WOSS-SmartHome/-smart-home-DOC/README.md

# DOC smart-home
 Lưu giữ các tài liệu chung của dự án
