WOSS-SmartHome/-smart-home-DOC/BOM list smarthome 6-sep.xlsx

Sheet: LN1_ACS71240
Comment | Description | Designator | Footprint | LibRef | Quantity
0.1uF | CAP CER 0.1uF 50V 10% 0603 SMD | C1, C2, C3, C4, C5, C6, C8 | 0603 C | 0603 0.1uF CER | 7
1nF | CAP CER 1nF 50V 10% 0603 SMD | C7, C9 | 0603 C | 0603 1nF CER | 2
1N4148 |  | D1, D2, D3, D4, D5, D6 | SOD-323 | Diode schottky | 6
TS4148C |  | D7, D8, D9 | 0603 D | Diode schottky | 3
LED smd |  | D10 | LED 0805 | LED smd | 1
FUSE |  | F1, F2, F3 | FUSE 6ET 10A250V | FUSE | 3
P5 1.27MM |  | JP1 | P5-1.27MM | P5 | 1
P1 |  | L1, N1, O1, O2, O3 | BRASS CONN | P1 | 5
10D751K | 750V | MOV1 | MOV | VARISTOR | 1
3904 |  | Q1, Q2, Q4, Q5, Q6, Q8, Q9, Q10, Q12 | SOT 23-3 - BCE | TRANS NPN_BCE | 9
3906 |  | Q3, Q7, Q11 | SOT 23-3 - BCE | TRANS PNP_BCE | 3
10k | 10k 1% 0603 SMD | R1, R2, R4, R5, R8, R9, R11, R12, R13, R14, R16, R20, R27, R29, R42, R45 | 0603 R | 0603 10k 1% | 16
0R | 0R 1% 0603 SMD | R3 | 0603 R | 0603 0R 1% | 1
100k | 100k 1% 0603 SMD | R6, R7, R10, R15, R18, R19, R30, R31, R41, R46, R47, R48, R49 | 0603 R | 0603 100k 1% | 13
RELAY CHOT |  | RL1, RL2, RL3 | HFE60 | RELAY CHOT | 3
P4 |  | SW1 | JST 4PIN - 2.54mm | P4 | 1
N76E003AT20 |  | U1 | TSSOP 20 P0.65 | N76E003_1 | 1
HC12 MODULE |  | U2 | P5 - 2.54mm | HC12 MODULE | 1
AC-DC 5V |  | U3 | AC-DC 5V K4H24 | P4 | 1
ACS712ELCTR-30A-T | ACS712ELCTR-20A SOIC 8 | U4 | SOIC 8 | ACS71240 | 1

Sheet: L
Comment | Description | Designator | Footprint | LibRef | Quantity
0.1uF | CAP CER 0.1uF 50V 10% 0603 SMD | C1, C2, C3, C5, C7, C8 | 0603 C | 0603 0.1uF CER | 6
1nF | CAP CER 1nF 50V 10% 0603 SMD | C4, C6 | 0603 C | 0603 1nF CER | 2
TAJA225K016RNJ | CAP-TAN 2.2uF 16V 10% 3216 SMD | C9, C10, C12, C13 | CAP-TAN 3216 | CAP-TAN 2.2uF 16V 3216 SMD | 4
TAJD227K010RNJ | CAP-TAN 220uF 10V 10% 7343 SMD | C14 | CAP-TAN 7343 | CAP-TAN 220uF 10V7343 SMD_1 | 1
TS4148C |  | D1, D2 | 0603 D | Diode schottky | 2
LED smd |  | D3 | LED 0805 | LED smd | 1
1N4007 |  | D4, D8 | DO214AC | Diode schottky | 2
0603 |  | D5, D12 | LED0603_1608 | LED smd | 2
SMAJ4735A | DIODE ZENER 6.2V 1W | D6, D7, D13, D14 | DO214AC | Diode Zener | 4
ZMM5V1 |  | D9, D10, D11 | SOD-80C | Diode Zener | 3
FUSE |  | F1, F2 | FUSE 6ET 10A250V | FUSE | 2
P5 1.27MM |  | JP1 | P5-1.27MM | P5 | 1
P1 |  | L1, O1, O2 | HOLE AC | P1 | 3
HC12 MODULE |  | P1 | HC12 MODULE | HC12 MODULE | 1
3906 |  | Q1, Q2 | SOT 23-3 - BCE | TRANS PNP_BCE | 2
3904 |  | Q3, Q4 | MMBT3904-SOT23 | TRANSITOR NPN | 2
10k | 10k 1% 0603 SMD | R1, R2, R4, R7, R13, R16 | 0603 R | 0603 10k 1% | 6
0R | 0R 1% 0603 SMD | R3 | 0603 R | 0603 0R 1% | 1
100k | 100k 1% 0603 SMD | R5, R6, R8, R14, R17 | 0603 R | 0603 100k 1% | 5
100R | 100R 1% 0603 SMD | R9, R11, R15 | 0603 R | 0603 100R 1% | 3
470R | 470R 1% 0603 SMD | R10, R12 | 0603 R | 0603 470R 1% | 2
P3 |  | SW1 | JST 3PIN - 2.54mm | P3 | 1
N76E003AT20 |  | U1 | TSSOP 20 P0.65 | N76E003_1 | 1
AC-DC 5V |  | U2 | DC-DC ISO BxxS LET | P4 | 1
ACS712ELCTR-30A-T | ACS712ELCTR-20A SOIC 8 | U3 | SOIC 8 | ACS71240 | 1
MOC3062 |  | U4, U6 | 6-PIN DIP | TRIAC & SCR | 2
DIODE BRIGH |  | U5 | MDB10S_MICRODIP_4SMD | DIODE BRIGH | 1
ACJT210 |  | U7, U8 | TO-252 | TRIAC | 2

Sheet: LN2
Comment | Description | Designator | Footprint | LibRef | Quantity
0.1uF | CAP CER 0.1uF 50V 10% 0603 SMD | C1, C2, C3, C5, C7, C10, C12 | 0603 C | 0603 0.1uF CER | 7
1nF | CAP CER 1nF 50V 10% 0603 SMD | C4, C6, C8, C9 | 0603 C | 0603 1nF CER | 4
TS4148C |  | D1, D2, D4, D5 | 0603 D | Diode schottky | 4
1N4148 |  | D3, D6 | SOD-323 | Diode schottky | 2
LED smd |  | D7 | LED 0805 | LED smd | 1
P5 1.27MM |  | JP1 | P5-1.27MM | P5 | 1
P1 |  | L, N, O1, O2 | HOLE AC | P1 | 4
10D751K | 750V | MOV1 | MOV | VARISTOR | 1
HC12 MODULE |  | P | HC12 MODULE | HC12 MODULE | 1
3904 |  | Q1, Q4 | SOT 23-3 - BCE | TRANS NPN_BCE | 2
3906 |  | Q2, Q3 | SOT 23-3 - BCE | TRANS PNP_BCE | 2
10k | 10k 1% 0603 SMD | R1, R2, R5, R6, R8, R11 | 0603 R | 0603 10k 1% | 6
0R | 0R 1% 0603 SMD | R3 | 0603 R | 0603 0R 1% | 1
100k | 100k 1% 0603 SMD | R4, R7, R9, R10, R12 | 0603 R | 0603 100k 1% | 5
SRA-05VDC-CL | 5VDC, 20A | RL1, RL2 | SRA-05VDC-CL | RELAY | 2
P3 |  | SW | JST 3PIN - 2.54mm | P3 | 1
N76E003AT20 |  | U1 | TSSOP 20 P0.65 | N76E003_1 | 1
AC-DC 5V |  | U2 | AC-DC 5V K4H24 | P4 | 1
ACS712ELCTR-30A-T | ACS712ELCTR-20A SOIC 8 | U3, U4 | SOIC 8 | ACS71240 | 2

Sheet: LN-WIFI
Comment | Description | Designator | Footprint | LibRef | Quantity
10uF | CAP CER 10uF 50V 10% 0805 SMD | C1, C9, C10 | 0805 C | 0805 10uF CER | 3
0.1uF | CAP CER 0.1uF 50V 10% 0603 SMD | C2, C3, C4, C5, C7 | 0603 C | 0603 0.1uF CER | 5
1nF | CAP CER 1nF 50V 10% 0603 SMD | C6, C8 | 0603 C | 0603 1nF CER | 2
TS4148C |  | D1 | 0603 D | Diode schottky | 1
LED smd |  | D2, D5 | LED0603_1608 | LED smd | 2
1N4148 |  | D3, D4 | SOD-323 | Diode schottky | 2
FUSE |  | F1 | FUSE 6ET 10A250V | FUSE | 1
P6 |  | JP1 | P6 - 1.27MM | P6 | 1
P1 |  | L1, O1 | BRASS CONN | P1 | 2
VARISTOR |  | MOV1 | MOV | VARISTOR | 1
P1 |  | N1 | HOLE AC | P1 | 1
3906 |  | Q1 | SOT 23-3 - BCE | TRANS PNP_BCE | 1
3904 |  | Q2, Q3, Q4 | SOT 23-3 - BCE | TRANS NPN_BCE | 3
10k | 10k 1% 0603 SMD | R1, R5, R8, R9, R10, R11, R15, R18 | 0603 R | 0603 10k 1% | 8
0R | 0R 1% 0603 SMD | R2, R3, R6 | 0603 R | 0603 0R 1% | 3
8.2k | 8.2k 1% 0603 SMD | R4 | 0603 R | 0603 8.2k 1% | 1
1k | 1k 1% 0603 SMD | R7 | 0603 R | 0603 1kR 1% | 1
100k | 100k 1% 0603 SMD | R12, R13, R14, R16, R17 | 0603 R | 0603 100k 1% | 5
P4 |  | RF1 | MODULE RF THU -2 | P4 | 1
RELAY CHOT |  | RL1 | HFE60 | RELAY CHOT | 1
P2 |  | SW | P2-2.54-SOCKET - RA | P2 | 1
MICRO-32 | MICRO-32 | U1 | ESP MICRO 32 | ESP MICRO-32 | 1
HC12 MODULE |  | U2 | HC12 MODULE | HC12 MODULE | 1
AC-DC 5V |  | U3 | AC-DC 5V K4H24 | P4 | 1
ACS712ELCTR-30A-T | ACS712ELCTR-20A SOIC 8 | U4 | SOIC 8 | ACS71240 | 1
LM1117 |  | U5 | SOT23-4 | LM1117 | 1

Sheet: SOCKET
Comment | Description | Designator | Footprint | LibRef | Quantity
B0505S |  | B1 | DC-DC ISO BxxS | P4 | 1
0.1uF | CAP CER 0.1uF 50V 10% 0603 SMD | C1, C2, C3, C6, C7, C10, C11 | 0603 C | 0603 0.1uF CER | 7
33nF | CAP CER 33nF 50V 10% 0603 SMD | C4, C5, C8, C9 | 0603 C | 0603 33nF CER | 4
TS4148C |  | D1, D2 | 0603 D | Diode schottky | 2
1N4148 |  | D3, D4, D7, D8 | SOD-323 | Diode schottky | 4
LED smd |  | D5, D6 | LED0603_1608 | LED smd | 2
FUSE |  | F1, F2 | FUSE 6ET 10A250V | FUSE | 2
P5 1.27MM |  | JP1 | P5-1.27MM | P5 | 1
P1 |  | L, N, O1, O2 | HOLE AC | P1 | 4
VARISTOR |  | MOV1 | MOV | VARISTOR | 1
HC12 MODULE |  | P | HC12 MODULE | HC12 MODULE | 1
3904 |  | Q1, Q4, Q5, Q6 | SOT 23-3 - BCE | TRANS NPN_BCE | 4
3906 |  | Q2, Q3 | SOT 23-3 - BCE | TRANS PNP_BCE | 2
10k | 10k 1% 0603 SMD | R1, R2, R4, R6, R8, R13, R27 | 0603 R | 0603 10k 1% | 7
0R | 0R 1% 0603 SMD | R3 | 0603 R | 0603 0R 1% | 1
100k | 100k 1% 0603 SMD | R5, R7, R9, R17, R29 | 0603 R | 0603 100k 1% | 5
1k | 1k 1% 0603 SMD | R10, R11, R12, R16, R18, R26, R28, R30, R31, R32, R35, R36, R44, R45 | 0603 R | 0603 1kR 1% | 14
5mR | 5mR 1% 2512 SMD | R14, R33 | 2512 R | RES 2512 5mR 1% | 2
330R | 330R 1% 0603 SMD | R15, R25, R34, R43 | 0603 R | 0603 330R 1% | 4
470k | 470k 1% 0805 SMD | R19, R20, R21, R22, R23, R24, R37, R38, R39, R40, R41, R42 | 0805 R | 0805 470k 1% | 12
G5RL-K1A-EL-HA |  | RL1, RL2 | RELAY LATCHING | RELAY 1 coil G5RL-K1A-EL-HA | 2
N76E003AT20 |  | U1 | TSSOP 20 P0.65 | N76E003_1 | 1
AC-DC 5V |  | U2 | AC-DC 5V K4H24 | P4 | 1
HLW8012 |  | U3, U7 | SOIC 8 | HLW8012 | 2
OPTO PC817 |  | U4, U5, U6, U8, U9, U10 | PC817 Tiny | OPTO | 6

Sheet: TỔNG HỢP
Comment | Description | Supplier | Footprint | LibRef | Quantity | LN1 | L | LN2 | LN-WIFI | SOCKET | IR | buy = qty*5
0.1uF | CAP CER 0.1uF 50V 10% 0603 SMD | theioiic | 0603 C | 0603 0.1uF CER | 32 | 7 | 6 | 7 | 5 | 7 |  | 160
1nF | CAP CER 1nF 50V 10% 0603 SMD | theioiic | 0603 C | 0603 1nF CER | 10 | 2 | 2 | 4 | 2 |  |  | 50
10uF | CAP CER 10uF 50V 10% 0805 SMD | C1, C9, C10 | 0805 C | 0805 10uF CER | 3 |  |  |  | 3 |  |  | stock
TAJA225K016RNJ | CAP-TAN 2.2uF 16V 10% 3216 SMD | theioiic | CAP-TAN 3216 | CAP-TAN 2.2uF 16V 3216 SMD | 4 |  | 4 |  |  |  |  | 20
TAJD227K010RNJ | CAP-TAN 220uF 10V 10% 7343 SMD | theioiic | CAP-TAN 7343 | CAP-TAN 220uF 10V7343 SMD | 1 |  | 1 |  |  |  |  | 5
TAJA106M010RNJ | Tantalum 10uF 10V | theioiic |  |  | 2 |  |  |  |  |  |  | 10
33nF | CAP CER 33nF 50V 10% 0603 SMD | theioiic | 0603 C | 0603 33nF CER | 4 |  |  |  |  | 4 |  | 20
10k | 10k 1% 0603 SMD | R1, R2, R4, R5, R8, R9, R11, R12, R13, R14, R16, R20, R27, R29, R42, R45 | 0603 R | 0603 10k 1% | 43 | 16 | 6 | 6 | 8 | 7 |  | stock
0R | 0R 1% 0603 SMD | R3 | 0603 R | 0603 0R 1% | 7 | 1 | 1 | 1 | 3 | 1 |  | 35
100k | 100k 1% 0603 SMD | R6, R7, R10, R15, R18, R19, R30, R31, R41, R46, R47, R48, R49 | 0603 R | 0603 100k 1% | 33 | 13 | 5 | 5 | 5 | 5 |  | stock
100R | 100R 1% 0603 SMD | theioiic | 0603 R | 0603 100R 1% | 3 |  | 3 |  |  |  |  | 15
470R | 470R 1% 0603 SMD | theioiic | 0603 R | 0603 470R 1% | 2 |  | 2 |  |  |  |  | 10
1k | 1k 1% 0603 SMD | theioiic | 0603 R | 0603 1kR 1% | 15 |  |  |  | 1 | 14 |  | 75
8.2k | 8.2k 1% 0603 SMD | theioiic | 0603 R | 0603 8.2k 1% | 1 |  |  |  | 1 |  |  | 5
330R | 330R 1% 0603 SMD | theioiic | 0603 R | 0603 330R 1% | 4 |  |  |  |  | 4 |  | 20
470k | 470k 1% 0805 SMD | R19, R20, R21, R22, R23, R24, R37, R38, R39, R40, R41, R42 | 0805 R | 0805 470k 1% | 12 |  |  |  |  | 12 |  | stock
5mR | 5mR 1% 2512 SMD | R14, R33 | 2512 R | RES 2512 5mR 1% | 2 |  |  |  |  | 2 |  | stock
1N4148 |  | theioiic | SOD-123 | Diode schottky | 14 | 6 |  | 2 | 2 | 4 |  | 70
TS4148C |  | theioiic | 0603 D | Diode schottky | 12 | 3 | 2 | 4 | 1 | 2 |  | 60
1N4007 |  | theioiic | DO214AC | Diode schottky | 2 |  | 2 |  |  |  |  | 10
1N4736A | DIODE ZENER 6.8V 1W | theioiic | DO214AC | Diode Zener | 4 |  | 4 |  |  |  |  | 20
ZMM5V1 |  | theioiic | SOD-80C | Diode Zener | 3 |  | 3 |  |  |  |  | 15
LED smd |  | theioiic | LED 0603 | LED smd | 9 | 1 | 3 | 1 | 2 | 2 |  | 45
FUSE | 250V 10A | dientuachau | FUSE 6ET 10A250V | FUSE | 8 | 3 | 2 |  | 1 | 2 |  | 40
P1 | Trụ PCB Nối Dây 5x6x9.5 V3 | theioiic | BRASS CONN | P1 | 7 | 5 |  |  | 2 |  |  | 35
10D751K | VARISTOR 750V | theioiic | MOV | VARISTOR | 4 | 1 |  | 1 | 1 | 1 |  | 20
3904 |  | theioiic | SOT 23-3 - BCE | TRANS NPN_BCE | 20 | 9 | 2 | 2 | 3 | 4 |  | 100
3906 |  | theioiic | SOT 23-3 - BCE | TRANS PNP_BCE | 10 | 3 | 2 | 2 | 1 | 2 |  | 50
RELAY CHOT |  | RL1, RL2, RL3 | HFE60 | RELAY CHOT | 4 | 3 |  |  | 1 |  |  | stock
SRA-05VDC-CL | 5VDC, 20A | RL1, RL2 | SRA-05VDC-CL | RELAY | 2 |  | 2 |  |  |  |  | 10
G5RL-K1A-EL-HA |  | RL1, RL2 | RELAY LATCHING | G5RL-K1A-EL-HA | 2 |  |  |  |  | 2 |  | stock
P4 | header 4 | SW1 | JST 4PIN - 2.54mm | P4 | 1 | 1 |  |  |  |  |  | 5
P3 | header 3 | SW1 | JST 3PIN - 2.54mm | P3 | 2 |  | 1 | 1 |  |  |  | 10
P2 | header 2 | SW | P2-2.54-SOCKET - RA | P2 | 1 |  |  |  | 1 |  |  | 5
CHJ-RXB1 | RF R 433MHz |  |  |  | 2 |  |  |  | 1 |  | 1 | stock
HC12 MODULE |  | theioiic | P5 - 2.54mm | HC12 MODULE | 5 | 1 | 1 | 1 | 1 | 1 |  | 25
N76E003AT20 |  | dientuachau | TSSOP 20 P0.65 | N76E003_1 | 4 | 1 | 1 | 1 |  | 1 |  | 20
AC-DC 5V |  | dientuachau | AC-DC 5V K4H24 | P4 | 4 | 1 |  | 1 | 1 | 1 |  | 20
ACS712ELCTR-30A-T |  | theioiic | SOIC 8 | ACS71240 | 2 |  |  | 2 |  |  |  | 10
ACS712ELCTR-20A-T |  | theioiic |  |  | 3 | 1 | 1 |  | 1 |  |  | 15
MICRO-32 | MICRO-32 | U1 | ESP MICRO 32 | ESP MICRO-32 | 2 |  |  |  | 1 |  | 1 | 10
LM1117 |  | U5 | SOT23-4 | LM1117 | 2 |  | 1 |  | 1 |  |  | stock
HLW8012 |  | U3, U7 | SOIC 8 | HLW8012 | 2 |  |  |  |  | 2 |  | 10
OPTO PC817 |  | U4, U5, U6, U8, U9, U10 | PC817 Tiny | OPTO | 6 |  |  |  |  | 6 |  | stock
MOC3063M |  | theioiic | 6-PIN DIP | TRIAC & SCR | 2 |  | 2 |  |  |  |  | 10
DB107S | diode bridge 1kV 1A | theioiic | MDB10S_MICRODIP_4SMD | DIODE BRIGH | 1 |  | 1 |  |  |  |  | 5
BT137S-600E |  | theioiic | TO-252 | TRIAC | 2 |  | 2 |  |  |  |  | 10

Sheet: Sheet6
Supplier | ID | pass
thegioiic.com | dientu@woss.com.vn | thegioiic
banlinhkien.com | dientu@woss.com.vn | banlinhkien
dientuachau.com | dientu@woss.com.vn | dientuachau

Sheet: Sheet1
No | Comment | Description | Designator | Quantity | Manufacture PN
1 | 0.1uF | CAP CER 0.1uF 25V 10% 0603 SMD | C1, C3, C10, C11, C12, C14 | 2 | GMC10X7R104J25NT
2 | 10uF | CAP CER 10uF 25V 10% 0805 SMD | C2, C5, C6 | 3 | 08053D106KAT4A
3 | 0.1uF | CAP CER 0.1uF 25V 10% 0805 SMD | C7, C8, C9 | 1 | CC0805ZRY5V8BB104
4 | LED 3MM | LED BLUE DIP 3MM | D2 | 1
5 | IR333-A | EMITTER IR 940NM 100MA RADIAL | IR2, IR3, IR4, IR5, IR6, IR7, IR8 | 7 | IR333-A
6 | TSOP1838 | TSOP1838 IR Receiver Module 38 kHz | IR1 | 1
7 | IRLML0030TRPBF | MOSFET N-CH 30V 5.3A SOT-23-3 | Q1 | 1 | FDV303N
8 | 10K | CRGCQ 0603 10K 1% | R1, R5,R7, R8 | 3 | A129700TR-ND
9 | 1K | RES 1K OHM 0.5% 1/10W 0603 | R2 | 1 | RNCF0603DTE1K00
10 | 35R | RES 35.7 OHM 1% 1/10W 0603 | R9, R10, R11, R12, R13, R14, R15 | 7 | RMCF0603FT35R7
11 | SW | Button 4 Pin SMD | SW3.5 | 1
12 | MICRO 32 | TTGO Micro-32 V2.0 WifiBluetooth Module ESP32 | U1 | 1
13 | LM1117 | IC REG LIN 3.3V 1mA SOT223-4 | U2 | 1
14 | USB Micro 2.0 | MICRO USB, TYPE B, RIGHT ANGLE,' | USB1 | 1 | MCR-B-S-RA-SMT-CS5A-NF-T/R
15 | ATSHA204A | IC AUTHENTICATION CHIP SOT23-3 | U3 | 1 | ATSHA204A-STUCZ-T
16 | 3.3K | RES 3.3K OHM 1% 1/10W 0603 | R16, R17, R18, R19 | 4 | RMCF0603FT3K30
17 | SN74LVC125A | IC BUF NON-INVERT 3.6V 14TSSOP | U4 | 1 | SN74LVC125AQPWRQ1
18 | Socket MicrO SD Push-Push | CONN MEM SECURE DIGITAL REV SMD | SD1 | 1
19 | RXB22 | RF 433Hz | RF | 1
