WOSS-SmartHome/-smart-home-DOC/Daily_Testing_Module-Zigbee-Ti-CC2530.xlsx

Sheet: Overview
TEST MODULE ZIGBEE TI CC2530
THIẾT BỊ:
5 module Zigbee Ti cc2530. Các module được đặt tên A, B, C, D, E như hình bên dưới
 |  | CẤU HÌNH:
 |  | Baudrate 9600:
 |  | Phương thức truyền: Broadcast
NHIỆM VỤ: | Test khoảng cách, thời gian và độ ổn định khi truyền nhận dữ liệu giữa các module
1. Test hoạt động truyền nhận tín hiệu của mỗi module
2. Test truyền nhận tín hiệu qua cổng UART giữa nhiều module (3, 4, 5,… module) đặt cùng vị trí
3. Test truyền nhận tín hiệu giữa 2 module (A truyền, B nhận) khi có thêm các module khác đặt giữa (mục đích mở rộng không gian truyền nhận tín hiệu)
- Case 1: Chỉ có module C đặt giữa A và B
- Case 2: Có module C và D đặt giữa A và B
- Case 3: Có module C, D, E đặt giữa A và B
4. Test truyền nhận tín hiệu khi lắp module (thay cho HC-12) vào PCB và đặt vào trong tường

Sheet: Working timeline
Thời gian | Công việc
Thứ sáu, 15/10/2021 | 1. Nhận 5 module Zigbee Ti CC2530
 | 2. Kết nối UART và Setup cấu hình cho từng module
 | 3. Test truyền nhận tín hiệu cho từng module
Thứ bảy, 16/10/2021 | 1. Test truyền nhận tín hiệu giữa nhiều module với nhau
Thứ hai, 18/10/2021 | 1. Test khoảng cách truyền nhận giữa module A và B
 | - Chỉ 2 module A và B
 | - Đặt module C giữa A và B
 | - Đặt module C, D và E giữa A và B
Thứ ba, 19/10/2021 | 1. Lắp module B vào PCB Smart Home (thay cho HC-12)
 | - Viết code, và nạp cho MCU gắn với module B (nhờ Trí)
 | - Test module với code đã nạp xem đã hoạt động đúng chưa
 | 2. Lắp bo mạch đã có module C vào công tắc điện âm tường
 | 3. Test truyền nhận giữa A và B
Thứ tư, 20/10/2021 | 1. Test khoảng cách truyền nhận (cùng a Hải) các trường hợp
 | - Test truyền nhận giữa A và B (module B đã lắp âm tường)
 | - Đặt một module C giữa A và B
 | - Nối Tx và Rx của module C với nhau

Sheet: Testing
 | Test Case
 | Project Name | Smart Home | Tên Module | Zigbee Ti CC2530
 | Test Case ID |  | Tốc độ truyền | Baudrate 9600 | Description
 | Version | V00 | Chanel | 2 LED bên dưới đỏ | Pre - Condition
 | Created By | N.Q Cường | Kiểu truyền nhận | Broadcast | Created Date |  | Executed By
 | Reviewed By |  |  |  | Reviewed Date |  | Result ( Pass / Fail)
Test ID | Test Scenarios | Description | Test Step | Test Data | Expected Result | Actual result | Status | Comments
1 | Ghi trường hợp test | Mô tả tình huống test | Các bước thực hiện của tình huống test | Dữ liệu sử dụng để thực hiện / vận hành bài test | Kết quả dự kiến đối với test case | Kết quả thực tế sau khi thực hiện test case | Đánh giá: Thành công / Thất bại | Nhận xét / Bình luận
Test ID | Test Scenarios | Description | Test Step | Test Data | Expected Result | Actual result | Status | Comments
1 | Test hoạt động truyền nhận của các module ở khoảng cách gần | Test truyền nhận tín hiệu cho từng cặp module | B1. Kết nối UART module A và B vào máy tính B2. Trên máy tính, mở phần mềm Terminal lên và kết nối với các module B3. Gửi tín hiệu truyền từ A, kiểm tra xem A có truyền đi không và B có nhận được tín hiệu không. Chú ý đến thời gian và dữ liệu nhận được B4. Truyền ngược lại từ B qua A và kiểm tra tương tự B5. Tương tự, kiểm tra truyền nhận với các module C, D, E | - A phát - B thu: trên Terminal gửi " A to B" - B phát - A thu: trên Terminal gửi " B to A". Tương tự cho các module C, D, E | - Led Tx trên A nháy báo hiệu đã gửi tín hiệu tới B - Led Rx trên B nháy báo hiệu B đã nhận tín hiệu. Trên Terminalkết nối với B hiển thị "A to B" | Đúng với dự kiến và mong muốn | Thành công | - 5 module truyền nhận 1 - 1 tốt ở khoảng cách gần (1 - 5m). - Ở chế độ Broadcast, 1 module có thể truyền tín hiệu cho nhiều module khác và ngược lại, một module có thể nhận tín hiệu từ nhiều module khác.
 |  | Test truyền nhận nhiều module (3, 4, 5,... module) | B1. Kết nối UART module A, B, C, D, E vào máy tính B2. Trên máy tính, mở phần mềm Terminal lên và kết nối với các module B3. Gửi tín hiệu truyền từ A , kiểm tra xem A có truyền đi không và các module còn lại có nhận được tín hiệu không. Chú ý đến thời gian và dữ liệu nhận được B4. Tương tự, gửi tín hiệu truyền từ B (C, D, E,...) và kiểm tra dữ liệu nhận các module còn lại. | - A phát, các module còn lại thu: Trên Terminal đã kết nối với A, gửi chuỗi "A to all" - Tương tự cho các module còn lại | - Led Tx trên A nháy báo hiệu đã gửi tín hiệu tới các module còn lại (B, C, D, E) - Led Rx trên B, C, D, E nháy báo hiệu đã nhận tín hiệu từ A. Trên Terminalkết nối với chúng hiển thị "A to all" | Đúng với dự kiến và mong muốn | Thành công
2 | Test khoảng cách truyền nhận giữa các module | Case 1: Truyền nhận 1 - 1 giữa A và B | B1. Chuẩn bị: - Kết nối UART module A vào laptop A/máy tính; module B vào laptop. - Bật và kết nối chúng vói Terminal - Setup trên Termial của A, gửi tín hiệu "Test Range A to B" liên tục với tần số 1 (1 giây gửi 1 lần) B2. Tiến hành test: Cầm laptop B (có module B) đi xa dần A cho đến khi B không còn nhận được bất kỳ tín hiệu nào từ A. Đó chính là khoảng cách xa nhất có thể truyền từ A qua B và ngược lại | - A đặt tại phòng R & D, lầu 3 của văn phòng công ty Woss. Phát chuỗi "Test Range A to B" với tần số 1 giây 1 lần. | Truyền nhận càng xa càng tốt Chờ kết quả thực tế | Chỉ truyền được từ lầu 3 (phòng R & D, vị trí ngồi của Đạt) xuống gần tới lầu 1 (ngay cửa phòng làm việc của anh Phúc) | Tạm ổn | - Nhận xét: Khoảng cách truyền Nhận không được xa như mong muốn (Gần 2 lầu). - Nguyên nhân: Có vật cản giữa đường truyền (Tường, kính, cầu thang, bàn, ghế,…)
 |  | Case 2: A truyền, B nhận. Bên cạnh đó, để các module C, D, E ở khoảng giữa A và B Mục đich: Test chế độ Broadcast, 2 module A và B có thể truyền nhận xa hơn không, nếu đặt vào giữa chúng C, D, E | B1.Chuẩn bị: - A và B: giữ y nguyên như ở test khoảng cách giữa A và B - C, D, E cắm vào cục sạc dự phòng (cho điện thoại) thông qua USB UART B2. Tiến hành test - Đặt 1 module C ở giữa vị trí mà A, B truyền nhận xa nhất . Như thực nghiệm đã làm ở trên, ta đặt C ở mé trên lầu 2 - Cầm laptop B có module B di chuyển xa dần so với A đến khi nào B không nhận được tín hiệu từ A thì dừng. B3. Ghi lại kết quả và đưa ra kết luận B4. Đặt thêm D và E vào gần C (C, D, E đặt giữa A và B) | - A đặt tại phòng R & D, lầu 3 của văn phòng công ty Woss. Phát chuỗi "Test Range A to B" với tần số 1 giây 1 lần. | Kỳ vọng: - C, D, E chuyển tiếp tín hiệu từ A tới B (chế độ Broadcast). Do vậy, tín hiệu sẽ được truyền đi xa hơn. => Khoảng cách truyền nhận tối đa từ A qua B tăng lên | Thực tế: Khoảng cách truyền nhận giữa A và B không tăng lên khi có C, D, E đặt giữa. (Vẫn chỉ từ lầu 3 tới lầu 1) | -Thực tế không đúng với kỳ vọng mà mong muốn ban đầu | Kết luận: Ở chế độ Broadcast, các module: - Chỉ nhận tín hiệu từ các module khác và không chuyển tiếp tín hiệu đi xa. - Không cộng hưởng hay khuếch đại tín hiệu.
5 | Test truyền nhận khi lắp bo mạch hoàn chỉnh (đã gắn module Zigbee) vào âm tường. | - A nối với máy tính (qua chuẩn UART) - B gắn vào bo mạch (có MCU) và lắp vào ổ điện âm tường. - Gửi chuỗi "Test module B" từ A tới B, sau đó B phản hồi lại "Module B OK" tới A | B1. Chuẩn bị: - Kết nối UART module A vào laptop A và chương trình Terminal; module B vào bo mạch Smart Home (có MCU). - Lập trình và nạp cho MCU (trên bo đã gắn B) lệnh phản hồi lại A khi nhận tín hiệu từ A. - Lắp bo mạch vào ổ điện âm tường (với nguồn cấp 220V AC) B2. Tiến hành test: - Từ A gửi lệnh với tần số 1 lần mỗi giây - Mang laptop kết nối với A đi xa B. Theo dõi và ghi nhận dữ liệu phản hồi từ B | - A liên tục phát ra chuỗi "Test module B" với tần số 1 lần mỗi giây - Khi B nhận được tín hiệu từ A, MCU sẽ phát ra chuỗi "Module B OK" - Chuỗi phản hồi từ B sẽ hiển thị trên giao diện Termial của máy tính gắn với A | Các module hoạt động tốt như khi chưa lắp âm tường (đã thực hiên ở những phần trước đó) | Đúng như dự kiến | Thành công | Bo mạch và module hoạt động tốt khi lắp vàođiện dân dụng 220V AC. Khoảng cách truyền nhận dữ liệu thay đổi rất nhỏ khi lắp vào ổ điện âm tường thực tế
6
7
8
9
10
