WOSS-SmartHome/-smart-home-DOC/Testing_Module-Zigbee.pptx

TEST KHOẢNG CÁCH TRUYỀN NHẬN
MODULE ZIGBEE TI CC2530

Ta có 5 Module Zigbee Ti CC2530,
để cho dễ theo dõi, ta sẽ đặt tên như bên dưới

A

B

C

D

E

Tất cả các module đều được setup như sau:
- Baudrate: 9600
- Chế độ truyền – nhận: Broadcast

## Slide 2

Test Case 1: Truyền nhận giữa 2 module

A

B

Máy tính
(MCU)

UART

ZIGBEE

UART

Máy tính
(MCU)

Các bước thực hiện:
1. Kết nối mỗi module A và B với máy tính (hoặc một MCU) qua chuẩn UART
2. Từ A phát tín hiệu “A sent to B” liên tục 1 giây/lần
3. Kiểm tra tín hiệu nhận được ở B
4. Cầm máy tính (MCU) có gắn B đi ra xa A, theo dõi tín hiệu nhận được tại 2 vị trí: + Vị trí xa nhất mà B có thể nhận tốt (hầu như không mất dữ liệu) tín hiệu từ A + Vị trí ngay khi B không nhận được tín hiệu từ A
5. Làm ngược lại: cho B phát – A thu

## Slide 3

Kết quả

1. Thời gian truyền – nhận dữ liệu: nhanh, gần như ngay lập tức
2. Khoảng cách truyền: - Không có vật cản: A và B truyền nhận rất tốt trong phạm vi 50m (có thể xa hơn) - Khi có vật cản, cụ thể là đặt A phát ở lầu 3, B là bộ phận thu: + Vị trí xa nhất mà A và B có thể truyền nhận ổn định: B ở lầu 2 + Vị trí xa nhất mà A và B có thể truyền nhận tín hiệu cho nhau: B ở lầu 1

Kết luận:
Khoảng cách truyền nhận giữa 2 module khi trong nhà là không quá xa (tối đa 2 tầng lầu), do vậy không thể dung cách này trong một ngôi nhà lớn, có nhiều tầng lầu
=> Mong muốn khoảng cách truyền nhận giữa 2 module lớn hơn.

## Slide 4

Test Case 2: Truyền nhận giữa 3 module trở lên (mesh)

A

B

E

C

D

Các trường hợp test:
1. Test truyền nhận giữa nhiều module (ở khoảng cách gần)
2. Test khoảng cách truyền nhận giữa 2 module A, B khi có C, D, E đặt giữa

## Slide 5

Truyền nhận tín hiệu giữa nhiều module (khoảng cách gần)

A

B

C

D

E

Các bước thực hiện:
1. Kết nối mỗi module A, B, C, D, E với máy máy tính (hoặc MCU) qua chuẩn UART.
2. Từ A phát tín hiệu “A sent to ALL” liên tục 1 giây/lần
3. Kiểm tra và ghi nhận các tín hiệu nhận được ở B, C, D, E
4. Làm tương tự lần lượt cho B, C, D, E phát, các module còn lại thu

ZIGBEE

Máy tính
(MCU)

UART

## Slide 6

Kết quả

1. Thời gian truyền – nhận dữ liệu: nhanh, gần như ngay lập tức
2. Tất cả các module B, C, D, E nhận được dữ liệu giống nhau và gần như cùng lúc (tương tự cho B, C, D, E phát, các module còn lại thu)
3. Các module thu: nhận dữ liệu độc lập với nhau và không bị ảnh hưởng lẫn nhau khi có 1 nguồn phát
4. Khoảng cách truyền – nhận xa nhất giữa A – B; A – C; A – D; A – E gần như bằng nhau.

## Slide 7

Truyền nhận tín hiệu giữa A và B khi có C, D, E đặt giữa

ZIGBEE

Nguồn
cục sạc dự phòng

C

D

E

Máy tính
(MCU)

UART

A

???

???

B

UART

Máy tính
(MCU)

ZIGBEE

ZIGBEE

???

ZIGBEE

Các bước thực hiện:
1. Kết nối mỗi module A, B với 2 máy máy tính (hoặc một MCU) khác nhau; cắm C, D, E vào cục sạc dự phòng qua chuẩn UART.
2. Đặt C ở vị trí chính giữa khoảng cách truyền nhận xa nhất của A và B (đã có ở Test case 1)
3. Từ A phát tín hiệu “A sent to B” liên tục 1 giây/lần
4. Đặt máy tính (MCU) có gắn B tại vị trí xa nhất (đã đo được từ Test case 1). Sau đó đi xa hơn nữa, kiểm tra tín hiệu nhận được từ A.

Chú thích: Những mũi tên và “???” màu đỏ chỉ là những giả thiết và kỳ vọng đặt ra,
cần kiểm chứng bằng thực nghiệm.

## Slide 8

Kết quả

Khoảng cách truyền nhận tín hiệu giữa A và B không tăng lên khi có C, D và E đặt giữa
Như vậy, sơ đồ ở đầu trang sẽ là như sau:

Nguồn
cục sạc dự phòng

C

D

E

ZIGBEE

A

B

Máy tính
(MCU)

UART

ZIGBEE

ZIGBEE

UART

Máy tính
(MCU)

Kết luận:
Các module C, D, và E chỉ như bộ phận thu nhận tín hiệu từ A mà không chuyển tiếp dữ liệu đi ra xa hơn.
Vậy trong môi trường tòa nhà/văn phòng hoặc chung cư cao tầng có tường dày và nhiều vật cản (tường, cửa kính, bàn ghế, cây,…), các module chỉ truyền nhận được dữ liệu được cho nhau khoảng cách tối đa 2 tầng lầu.

## Slide 9

TỔNG KẾT

Module Zigbee Ti CC2530 khi ở chế độ Broadcast:

1. Lệnh truyền nhận đáp ứng ngay lập tức và không bị cộng dồn dữ liệu khi truyền nhận.
2. Có thể truyền nhận dữ liệu với nhau ở khoảng cách - Trong môi trường thoáng đãng: lên tới hàng trăm mét - Trong môi trường tòa nhà, cao ốc có nhiều vật cản: 2 tầng lầu
3. Trong một hệ thống gồm nhiều module: - 1 module có thể truyền dữ liệu đồng thời cho nhiều module, đồng thời có thể nhận dữ liệu từ nhiều module khác - Các module chỉ có thể truyền nhận trực tiếp qua lẫn nhau (không có mesh). Do vậy, khoảng cách truyền nhận dữ liệu chỉ giới hạn trong khoảng cách truyền nhận tối đa của 2 module.

## Slide 10

TEST KHOẢNG CÁCH TRUYỀN NHẬN MODULE ZIGBEE NXP E75

Sử dụng chip NXP E75 làm module zigbee

Tất cả các module đều được setup như sau:
- Baudrate: 115200
- Chế độ truyền – nhận: Broadcast

Ta có 2 test case:
- Test case 1: test khoảng cách truyền nhận giữa 2 module (A và B)
- Test case 2: test hoạt động lưới zigbee (mesh) của module

## Slide 11

Test Case 1: Truyền nhận giữa 2 module

Máy tính
(MCU)

UART

A

ZIGBEE

B

UART

Máy tính
(MCU)

1. Điều kiện thực nghiệm:
- Trong một tòa nhà gồm 4 tầng lầu (cụ thể: văn phòng công ty cổ phần Woss)
- 1 module phát A đặt tại lầu 3 (phòng kỹ thuật). Tín hiệu phát: “Wellcome to server”
- 1 module thu B kết nối với máy tính qua cổng UART, có thể cầm tay di chuyển được.

2. Kết quả thực nghiệm:
- Thời gian truyền – nhận dữ liệu: nhanh, gần như ngay lập tức
- Khoảng cách xa nhất nhận dữ liệu tốt và ổn định: 1 tầng (module thu tại lầu 2)
- Khoảng cách xa nhất nhận được dữ liệu (mặc dù không ổn định, mất dữ liệu): 1 tầng rưỡi (module thu tại cầy thang giữa tầng 1 và tầng 2)

## Slide 12

Test Case 2: Hoạt động lưới Zigbee (mesh) của module

ZIGBEE

C

Máy tính
(MCU)

UART

A

ZIGBEE

ZIGBEE

B

UART

Máy tính
(MCU)

1. Điều kiện thực nghiệm:
- Trong một tòa nhà gồm 4 tầng lầu (cụ thể: văn phòng công ty cổ phần Woss)
- 1 module phát A đặt tại lầu 3 (phòng kỹ thuật). Tín hiệu phát: “Wellcome to server”
- 1 module thu B kết nối với máy tính qua cổng UART, có thể cầm tay di chuyển được.
- 1 module trung gian C có nguồn (kết nối với cục sạc dự phòng) đặt tại lầu 2

2. Kết quả thực nghiệm:
- Thời gian truyền – nhận dữ liệu: nhanh, gần như ngay lập tức
- Khoảng cách xa nhất nhận dữ liệu tốt và ổn định: 2 tầng (module thu tại lầu 1)
- Khoảng cách xa nhất nhận được dữ liệu (mặc dù không ổn định, mất dữ liệu): 2 tầng rưỡi (module thu tại cầy thang giữa tầng 1 và tầng trệt)

=> Mesh hoạt động

## Slide 13

So sánh Module Zigbee sử dụng Ti CC2530 và NXP E75

| Ti CC 2530 | NXP E75
Supply voltage | 3 – 5.5V (proposal 5V) | 2 -3.6V (proposal 3.3V)
Energy consumption | Very low | Very low
Range transmit – receive between 2 modules | Larger (2 floors) | Smaller (1 floor and a half)
Mesh | No | Yes
