WOSS-SmartHome/-smart-home-DOC/TEST CASE_SH_New_V0.xlsx

Sheet: Overview
 |  |  | SMART HOME PROJECT
 |  |  | TEST CASE NODE
Version: 00
Time: yyyy/mm/dd
 | Requirements |  |  | Sheet
 | Gateway node | 1 | Swich N-Line 3 Relays 10A WiFi (Micro32 + NXP Zigbee Module) - LN | Test case_Detail_Switch Test case_Detail_Gateway
 | Normal node | 2 | Swich N-Line 3 Relays 10A (NXP Zigbee Module) - LN1 | Test case_Detail_Switch
 |  | 3 | IR Remote (Micro32 + IR Led + IR Receiver + NXP Zigbee Module) | Test case_Detail_IR
 |  | 4 | Swith Non N-Line 2 Relays (NXP Zigbee Module) - L | Test case_Detail_Switch
 |  | 5 | Socket 2 Relays 12A (NXP Zigbee Module) - SOCKET | Test case_Detail_Switch
 |  | 6 | Dimmer Switch (NXP Zigbee Module) | Test case_Detail_Dimmer

Sheet: Test case_Detail_Switch
Áp dụng cho các Node |  |  |  |  | Mục đích Test
1. Swich N-Line 3 Relays 10A WiFi (Micro32 + NXP Zigbee Module) - LN (bỏ qua chức năng gateway, chức năng này sẽ có 1 sheet riêng) |  |  |  |  | Kiểm tra đáp ứng đóng mở của relay dưới sự điều khiển của: Công tắc Apps (hoặc MCU)
2. Swich N-Line 3 Relays 10A (NXP Zigbee Module) - LN1
3. Swith Non N-Line 2 Relays (NXP Zigbee Module) - L
4. Socket 2 Relays 12A (NXP Zigbee Module) - SOCKET
Tên Node:
Tên Test case | Test case | Mục tiêu test | Điều kiện test | Yêu cầu input | Nội dung thực hiện | Kết quả mong đợi | Kết quả thực tế | Hình ảnh/video thực nghiệm | Bình luận
TC-01 | Bật tắt relay với nguồn cấp 5VDC | Kiểm tra bật tắt bằng công tắc cơ | Môi trường làm việc trong phòng. Nhiệt độ phòng: 25 độ C. Không tải. | 5VDC | 1. Nối công tắc cơ vào mạch Switch. 2. Dùng máy nguồn nối với đầu ra module nguồn (Vcc & GND). 3. Bật tắt công tắc và nghe tiếng đóng mở của relay | 1. Tương tác giữa công tắc và relay là 1- 1. (Công tắc thay đổi trạng thái thì relay cũng thay đổi trạng thái theo) 2. Relay đáp ứng gần như ngay lập tức | Đúng/ sai
 |  | Kiểm tra hoạt động bật tắt bằng MCU (qua giao diện Terminal) |  |  | 1. Dùng máy nguồn nối với đầu ra module nguồn (Vcc & GND). 2. Kết nối switch với máy tính thông qua cổng USB UART 3. Dùng Terminal để bật tắt relay | 1. Tương tác giữa lệnh từ terminal và relay là 1- 1. (Yêu cầu truyền đi từ Terminal thay đổi trạng thái thì relay cũng thay đổi trạng thái theo) 2. Relay đáp ứng gần như ngay lập tức yêu cầu từ MCU | Đúng/ sai
TC-02 | Bật tắt relay với nguồn cấp 220VAC-50Hz | Kiểm tra hoạt động bật tắt bằng công tắc | Môi trường làm việc trong phòng. Nhiệt độ phòng: 25 độ C. Có tải. | 220VAC-50Hz (điện dân dụng) | 1. Nối công tắc cơ vào mạch Switch. 2. Nối phích cắm với đầu vào module nguồn (L & N) thông qua một CB điện (Aptomat). 3. Nối tải (bóng đèn) vào đầu ra tải ở mỗi relay. 3.Cắm phích cắm vào ổ điện dân dụng 220VAC 4. Bật tắt công tắc và theo dõi hoạt động của tải (bóng đèn). | 1. Bóng đèn ở mỗi relay sáng tắt theo sự thay đổi trạng thái công tắc 2. Mạch Switch không bị nóng trong thời gian dài (khoảng 15 - 30 phút), không cháy nổ. | Đúng/sai
 |  | 1. Kiểm tra hoạt động bật tắt bằng MCU 2. Kiểm tra truyền nhận tín hiệu giữa máy tính (đóng vai trò như gateway) và Switch |  |  | 1. Kết nối 1 module truyền thông Zigbee với máy tính. 2. Nối phích cắm với đầu vào module nguồn (L & N) thông qua một CB điện (Aptomat). 3. Nối tải (bóng đèn) vào đầu ra tải ở mỗi relay. 4.Cắm phích cắm vào ổ điện dân dụng 220VAC 5. Dùng Terminal gửi tín hiệu tới Swich để bật tắt đèn | 1. Bóng đèn ở mỗi relay sáng tắt theo yêu cầu từ Terminal 2. Thời gian đáp ứng gần như ngay lập tức 3. Không bị miss yêu cầu từ Terminal tới Switch 4. Mạch Switch không bị nóng trong một khoảng thời gian (khoảng 15 - 30 phút), không cháy nổ. | Đúng/sai
TC-03 | Bật tắt relay liên tục | Kiểm tra hoạt động của switch khi bật tắt liên tục bằng công tắc | Môi trường làm việc trong phòng. Nhiệt độ phòng: 25 độ C. Có tải. | 220VAC-50Hz (điện dân dụng) | 1. Các bước chuẩn bị và cách mắc tương tự như phần kiểm tra đóng mở bằng công tắc của TC-02 2. Bật tắt công tắc liên tục (0.5s/lần bật tắt) và theo dõi hoạt động của tải (đèn). | 1. Bóng đèn ở mỗi relay sáng tắt theo yêu cầu từ Terminal 2. Thời gian đáp ứng gần như ngay lập tức 3. Không bị miss yêu cầu từ Terminal tới Switch 4. Mạch Switch không bị nóng trong một khoảng thời gian (khoảng 15 - 30 phút), không cháy nổ. | Đúng/sai
 |  | Kiểm tra hoạt động của switch khi bật tắt liên tục bằng MCU |  |  | 1. Các bước chuẩn bị và cách mắc tương tự như phần kiểm tra bật tắt bằng MCU của TC-02 2. Gửi các lệnh yêu cầu bật tắt liên tục (0.5s/lần bật tắt) và theo dõi hoạt động của đèn. | 1. Bóng đèn ở mỗi relay sáng tắt theo yêu cầu từ Terminal 2. Thời gian đáp ứng gần như ngay lập tức 3. Không bị miss yêu cầu từ Terminal tới Switch 4. Mạch Switch không bị nóng trong một khoảng thời gian (khoảng 15 - 30 phút), không cháy nổ. | Đúng/sai
TC-04 | Bật tắt cùng lúc 3 relay | Kiểm tra hoạt động của switch khi bật tắt cùng lúc bằng công tắc | Môi trường làm việc trong phòng. Nhiệt độ phòng: 25 độ C. Có tải. | 220VAC-50Hz (điện dân dụng) | 1. Các bước chuẩn bị và cách mắc tương tự như phần kiểm tra bật tắt bằng công tắc của TC-02 2. Bật tắt cùng lúc 3 công tắc nhiều lần và theo dõi hoạt động của tải (đèn). | 3 Bóng đèn sẽ sáng tắt theo thứ tự nhưng ách nhau khoảng thời gian rất ngắn (gần như cùng lúc)
 |  | Kiểm tra hoạt động của switch khi bật tắt cùng lúc bằng MCU |  |  | 1. Các bước chuẩn bị và cách mắc tương tự như phần kiểm tra bật tắt bằng MCU của TC-02 2. Gửi các lệnh yêu cầu bật tắt cùng lúc (1s 1 lần) 3 relay và theo dõi hoạt động của đèn.
TC-05 | Đọc cảm biến nhiệt độ | Kiểm tra chức năng đọc nhiệt dộ | Môi trường làm việc trong phòng. Nhiệt độ phòng: 25 độ C. Có tải. | 220VAC-50Hz (điện dân dụng) | 1. Các bước chuẩn bị và cách mắc tương tự như phần kiểm tra bật tắt bằng MCU của TC-02 2. Trên Terminal nhập lệnh yêu cầu Switch gửi giá trị nhiệt độ về máy tính. 3. Thay đổi nhiệt độ nơi gắn Swith, sau đó theo dõi phản hồi từ Switch. Một số cách thay đổi nhiệt độ: - Tắt máy lạnh, mở cửa - Gắn Switch ở nơi khác - Gửi yêu cầu ở nhiều thời điểm khác nhau trong ngày. | 1. Switch phản hồi nhanh chóng (dưới 1s) 2. Giá trị nhiệt độ nhận được chính xác. Sai số??? (5% / +-2 độ???) | Đúng/sai | Hình ảnh Terminal trên máy tính
TC-06 | Đọc công suất tiêu thụ | Kiểm tra chức năng đọc công suất tiêu thụ | Môi trường làm việc trong phòng. Nhiệt độ phòng: 25 độ C. Có tải. | 220VAC-50Hz (điện dân dụng) | 1. Các bước chuẩn bị và cách mắc tương tự như phần kiểm tra bật tắt bằng MCU của TC-02 2. Trên Terminal nhập lệnh yêu cầu Switch gửi giá trị công suất về máy tính. | 1. Switch phản hồi nhanh chóng (dưới 1s) 2. Giá trị công suất nhận được chính xác. Sai số??? | Đúng/sai | Hình ảnh Terminal trên máy tính
TC-07 | Đo khoảng cách truyền nhận tín hiệu của Switch (Từ máy tính tới Switch bằng module Zigbee) | Kiểm tra hoạt động của module truyền thông. | Môi trường làm việc trong phòng. Nhiệt độ phòng: 25 độ C. Có tải. | 220VAC-50Hz (điện dân dụng) | 1. Các bước chuẩn bị và cách mắc tương tự như phần kiểm tra bật tắt bằng MCU của TC-02 2. Gửi tín hiệu liên tục (1s 1 lần) tới Switch và yêu cầu Switch phản hồi lại máy tính (ký tự, số,…) 3. Mangmáy tính di chuyển xa dần với Switch. Theo dõi tín hiệu phản hồi từ Switch | 1. Máy tính và Switch trong cùng 1 lầu: - Tín hiệu phản hồi ngay lập tức - Không bị mất bất kỳ gói tin nào 2. Máy tính và Switch cách nhau 1 tầng lầu: - Tín hiệu phản hồi ngay lập tức - Gói tin tin bị mất < 5%? 3. Máy tính và Switch cách nhau 1.5 tầng lầu: - Tín hiệu phản hồi ngay lập tức - Gói tin tin bị mất < 10%? | Đúng/sai
TC-08 | Test ảnh hưởng bởi các yếu tố bên ngoài | Test khả năng lọc nhiễu dưới tác động của: - Máy khoan - Máy hàn điện | Môi trường làm việc trong phòng. Nhiệt độ phòng: 25 độ C. Có tải. | 220VAC-50Hz (điện dân dụng) | 1. Các bước chuẩn bị và cách mắc tương tự như phần kiểm tra bật tắt bằng MCU của TC-02 2. Dùng Terminal gửi tín hiệu bật tắt đèn 1s 1 lần tới Switch 3. Chạy máy khoan tường công suất lớn (chỉ nhấn cho mũi khoan xoay, không khoan vào tường. Chú ý đến an toàn) ngay bên cạnh Switch. Theo dõi xem đèn có sáng tắt như lúc chưa có máy khoan không. 4. Tương tự với máy hàn điện | Các bóng đèn vẫn tắt mở với chu kỳ 1s 1 lần
 |  | Test khả năng chống sét của thiết bị???

Sheet: Test case_Detail_Gateway
Áp dụng cho chức năng gateway của |  |  |  |  | Mục đích Test
Swich N-Line 3 Relays 10A WiFi (Micro32 + NXP Zigbee Module) - LN |  |  |  |  | Test xử lý truyền nhận trung gian giữa cloud và các node
Tên Node: Swich N-Line 3 Relays 10A WiFi (Micro32 + NXP Zigbee Module) - LN
Test case | Thể loại test | Mục tiêu test | Điều kiện test | Yêu cầu input | Nội dung thực hiện | Kết quả mong đợi | Kết quả thực tế | Hình ảnh thực nghiệm | Bình luận
TC-01 | Xử lý truyền - nhận đơn tác vụ cho 1 node | Kiểm tra truyền - nhận chức năng đọc trạng thái relay | Môi trường làm việc trong phòng. Nhiệt độ phòng: 25 độ C. | 220VAC-50Hz (điện dân dụng) | Do chưa có Apps nên ta chưa thể truyền lệnh từ cloud thực xuống được. Vì vậy, ta làm như sau: 1. Kết nối máy tính A với module zigbee qua USB UART. A đóng vai trò như cloud 2. Kết nối gateway với máy tính B qua USB UART. B đóng vai trò như gateway. 3. Cấp nguồn và nối các tải (đèn) 4. Từ máy tính A, truyền lệnh đọc trạng thái relay gửi cho B 5. Theo dõi lệnh đọc trạng thái nhận được ở B và trạng thái relay được gửi tới ở A đồng thời so sánh với trạng thái của đèn (sáng/tắt). | 1. Cửa sổ Receive của Terminal máy B: xuất hiện chuỗi lệnh đọc trạng thái relay. 2. Gần như ngay lập tức sau đó, cửa sổ Receve của Terminal máy A hiển thị trạng thái relay ON hoặc OFF 3. Trạng thái đèn: - Cửa sổ Receive của A hiện ON tương ứng với đèn sáng - Cửa sổ Receive của A hiện OFF tương ứng với đèn tắt. | Đúng/ sai |  | 1. Có thể dùng nguồn 5VDC cấp cho các Node để test thay vì 220VAC. Lưu ý: - Nếu cấp nguồn 5VDC thì cấp vào 2 chân đầu ra của mạch nguồn (Vcc & GND) - Nếu cấp nguồn 220VAC-50Hz thì cấp vào 2 chân đầu vào mạch nguồn (L & N). Cực kỳ chú ý đến AN TOÀN khi sử dụng điện dân dụng. 2. Để phục vụ cho mục đích test, các node và gateway đã được nạp sẵn code firmware.
TC-02 |  | Kiểm tra truyền - nhận chức năng đóng mở relay |  |  | 1. Kết nối và setup giữ nguyên như ở trên (TC-01) 2. Từ máy tính A, truyền lệnh đóng/mở relay gửi cho B 3. Theo dõi lệnh nhận được ở B và trạng thái của đèn. | 1. Cửa sổ Receive của Terminal máy B: xuất hiện chuỗi yêu cầu bật/tắt relay. 2. Gần như ngay lập tức sau đó, đèn sáng/tắt | Đúng/ sai
TC-03 |  | Kiểm tra truyền - nhận chức năng đọc nhiệt độ |  |  | 1. Kết nối và setup giữ nguyên như ở trên (TC-01) 2. Từ máy tính A, truyền lệnh đọc giá trị nhiệt độ gửi cho B 3. Theo dõi lệnh nhận được ở B và giá trị phản hồi hiển thị lại A. So sánh với giá trị nhiệt kế đo được (nếu có). | 1. Cửa sổ Receive của Terminal máy B: xuất hiện chuỗi yêu cầu đọc nhiệt độ. 2. Gần như ngay lập tức sau đó, của sổ Receive Terminal máy B hiển thị giá trị nhiệt độ. 3. Giá trị nhiệt độ hiển thị trên A phải gần đúng với giá trị thực tế (25 độ C). Sai số 5%? | Đúng/ sai
TC-04 |  | Kiểm tra truyền - nhận chức năng đọc công suất |  |  | 1. Kết nối và setup giữ nguyên như ở trên (TC-01) 2. Từ máy tính A, truyền lệnh đọc giá trị nhiệt độ gửi cho B 3. Theo dõi lệnh nhận được ở B và giá trị phản hồi hiển thị lại A. So sánh với giá trị công suất thực tế (nếu có). | 1. Cửa sổ Receive của Terminal máy B: xuất hiện chuỗi yêu cầu đọc công suất. 2. Gần như ngay lập tức sau đó, của sổ Receive Terminal máy B hiển thị giá trị nhiệt độ. 3. Giá trị công suất hiển thị trên A phải gần đúng với giá trị thực tế. Sai số 5%? | Đúng/ sai
TC-05 | Xử lý truyền - nhận đa tác vụ đồng thời cho 1 node | Kiểm tra khả năng truyền-nhận và xử lý nhiều yêu cầu cùng tại một thời điểm | Môi trường làm việc trong phòng. Nhiệt độ phòng: 25 độ C. | 220VAC-50Hz (điện dân dụng) | 1. Kết nối và setup giữ nguyên như ở trên (TC-01) 2. Từ máy tính A, gửi lần lượt nhiều lệnh khác nhau cách nhau 0.1s Ví dụ: - Đóng relay1 - Đọc trạng thái relay3, sau đó toogle - Đọc công suất trên tải 2 ... 3. Theo dõi lệnh nhận được ở B; giá trị phản hồi hiển thị lại A và hoạt động của tải | 1. Tất cả tác tác vụ đều được thực hiện 2. Thời gian đáp ứng các tác vụ nhanh | Đúng/ sai
TC-06 | Xử lý truyền - nhận đơn tác vụ cho nhiều node | Kiểm tra khả năng truyền-nhận và xử lý một yêu cầu cho nhiều node | Môi trường làm việc trong phòng. Nhiệt độ phòng: 25 độ C. | 220VAC-50Hz (điện dân dụng) | 1. Ở đây, ta kết nối thêm 1, 2 hay nhiều Node vào máy tính B. Lưu ý: bao nhiêu Node kết nối với máy tính B thì có bấy nhiêu cửa sổ Terminal được bật 2. Còn lại các bước thực hiện và kiểm tra giống như với đối với 1 Node đã trình bày ở phần trước đó. 3. Bước cuối cùng: so sánh sự hoạt động của các node với nhau. | 1. Tất cả tác Node đều thực hiện tác vụ gần như đồng thời. 2. Thời gian đáp ứng tác vụ của các Node nhanh. | Đúng/ sai
TC-07 | Xử lý truyền - nhận đa tác vụ cho nhiều node | Kiểm tra khả năng truyền-nhận và xử lý nhiều yêu cầu cho nhiều node | Môi trường làm việc trong phòng. Nhiệt độ phòng: 25 độ C. | 220VAC-50Hz (điện dân dụng) | 1. Giữ nguyên kết nối và setup như ở TC-06. 2. Trên A, ta gửi liên tục các lệnh tới các Node và nhận phản hồi. Ví dụ: - Đóng relay 1 trên Node3 - Đọc nhiệt độ trên Node1 - Đọc công suất trên tải 3 của Node4 - Mở relay2 trên Node 2. | 1. Tất cả tác Node đều thực hiện đầy đủ các tác vụ và gần như đồng thời. 2. Thời gian đáp ứng tác vụ của các Node nhanh. | Đúng/ sai

Sheet: Test case_Detail_IR
Áp dụng cho các Node |  |  |  |  | Mục đích Test
IR Remote (Micro32 + IR Led + IR Receiver + NXP Zigbee Module) |  |  |  |  | Kiểm tra khả năng và khoảng cách điều khiển máy lạnh của Node IR Kiểm tra sự phù hợp độ dày nắp housing
Tên Node:
Test case | Thể loại test | Mục tiêu test | Điều kiện test | Yêu cầu input | Nội dung thực hiện | Kết quả mong đợi | Kết quả thực tế | Hình ảnh thực nghiệm | Bình luận
TC-01 | Điều khiển 1 máy lạnh bằng IR | 1. Kiểm tra LED IR phát và thu có hoạt động tốt không. 2. Kiểm tra có điều khiển được máy lạnh như mong muốn không? 3. Biết được độ dày và kích thước housing đã phù hợp hay chưa. | Môi trường làm việc trong phòng. Nhiệt độ phòng: 25 độ C Không housing. | 5VDC | 1. Cấp nguồn mạch IR. 2. Kết nối mạch IR và điện thoại/mát tính bằng apps (nếu chưa có apps, có thể dùng tạm các apps nguồn mở). Sau đó thực hiện điều khiển máy lạnh Các lệnh điều khiển như: - Bật/Tắt - Nhiệt độ - Tốc độ gió - Swing - Hẹn giờ bật/tắt … | 1.Máy lạnh đáp ứng tức thì các lệnh điều khiển. Các lệnh truyền đi từ IR node không bị miss. | Đúng/ sai
 |  |  | Môi trường làm việc trong phòng. Nhiệt độ phòng: 25 độ C Có housing. |  |  |  | Đúng/ sai
TC-02 | Khoảng cách điều khiển | 1.Đo khoảng cách tối đa mà IR có thể điều khiển được máy lạnh 2. Biết được độ dày và kích thước housing đã phù hợp hay chưa. | Môi trường làm việc trong phòng. Nhiệt độ phòng: 25 độ C Không housing. | 5VDC | 1. Giữ nguyên cách mắc như trên (TC-01), vừa điều khiển 2. Đặt Node IR ra xa dần và điều khiển máy lạnh. Từ đó tìm được khoảng cách xa nhất ở mỗi trường hợp (có và không có housing) | 1. Khoảng cách mà IR node điều khiển được trong cả 2 trường hợp phải >10m 2. Máy lạnh đáp ứng tức thì các lệnh điều khiển. Các lệnh truyền đi từ IR node không bị miss. | Đúng/ sai
 |  |  | Môi trường làm việc trong phòng. Nhiệt độ phòng: 25 độ C Có housing. |  |  |  | Đúng/ sai
TC-03 | Test ảnh hưởng nhiễu bởi các yếu tố bên ngoài | Test khả năng lọc nhiễu dưới tác động của: - Máy khoan - Máy hàn điện | Môi trường làm việc trong phòng. Nhiệt độ phòng: 25 độ C Không housing. | 5VDC | 1. Giữ nguyên cách mắc và kết nối như ở các phần trên 2. Chạy máy khoan tường công suất lớn (chỉ nhấn cho mũi khoan xoay, không khoan vào tường. Chú ý đến an toàn) ngay bên cạnh máy lạnh. 3. Điều khiển máy lạnh bằng IR. Theo dõi xem máy lạnh có hoạt động như mong muốn không 4. Tương tự với máy hàn điện | Máy lạnh hoạt động như theo lệnh của IR. Không bị ảnh hưởng bởi nhiễu | Đúng/ sai
 |  |  | Môi trường làm việc trong phòng. Nhiệt độ phòng: 25 độ C Có housing. |  |  |  | Đúng/ sai

Sheet: Test case_Detail_Dimmer
Áp dụng cho các Node sau: |  |  |  |  | Mục đích Test
Dimmer Switch (NXP Zigbee Module) |  |  |  |  | Test hoạt động của Dimmer
Tên Node: Dimmer Switch (NXP Zigbee Module)
Test case | Thể loại test | Mục tiêu test | Điều kiện test | Yêu cầu input | Nội dung thực hiện | Kết quả mong đợi | Kết quả thực tế | Hình ảnh/video thực nghiệm | Bình luận
TC-01 | Test hoạt động Dimmer | Kiểm tra hoạt động bình thường của Dimmer khi PWM thay đổi từ từ | Môi trường làm việc trong phòng. Nhiệt độ phòng: 25 độ C. Có tải. | 220VAC-50Hz (điện dân dụng) | 1. Nối nút vặn cơ vào mạch Dimmer. 2. Nối phích cắm với đầu vào module nguồn (L & N) thông qua một CB điện (Aptomat). 3. Nối bóng đèn vào đầu ra tải. 3. Vặn công tắc và theo dõi sự thay đổi độ sáng của đèn | 1. Độ sáng đèn tăng giảm từ từ theo hành động vặn nút. | Đúng/ sai |  | Có thể dùng nguồn 5VDC cấp cho các Node để test thay vì 220VAC. Lưu ý: - Nếu cấp nguồn 5VDC thì cấp vào 2 chân đầu ra của mạch nguồn (Vcc & GND) - Nếu cấp nguồn 220VAC-50Hz thì cấp vào 2 chân đầu vào mạch nguồn (L & N). Cực kỳ chú ý đến AN TOÀN khi sử dụng điện dân dụng.
TC-02 | Test hoạt động Dimmer khi thay đổi liên tục và đột ngột | Kiểm tra hoạt động Dimmer khi Duty Cycle PWM thay đổi liên tục và đột ngột |  |  | 1. Giữ nguyên lắp đặt như ở trên (TC-01) 2. Vặn công tắc dimmer thật nhanh và thay đổi liên tục 3. Theo dõi sự thay đổi độ sáng của bóng đèn |  | Đúng/ sai
TC-03
TC-04
