WOSS-SmartHome/-smart-home-DOC/SMART HOME - SCHEMATIC.pdf

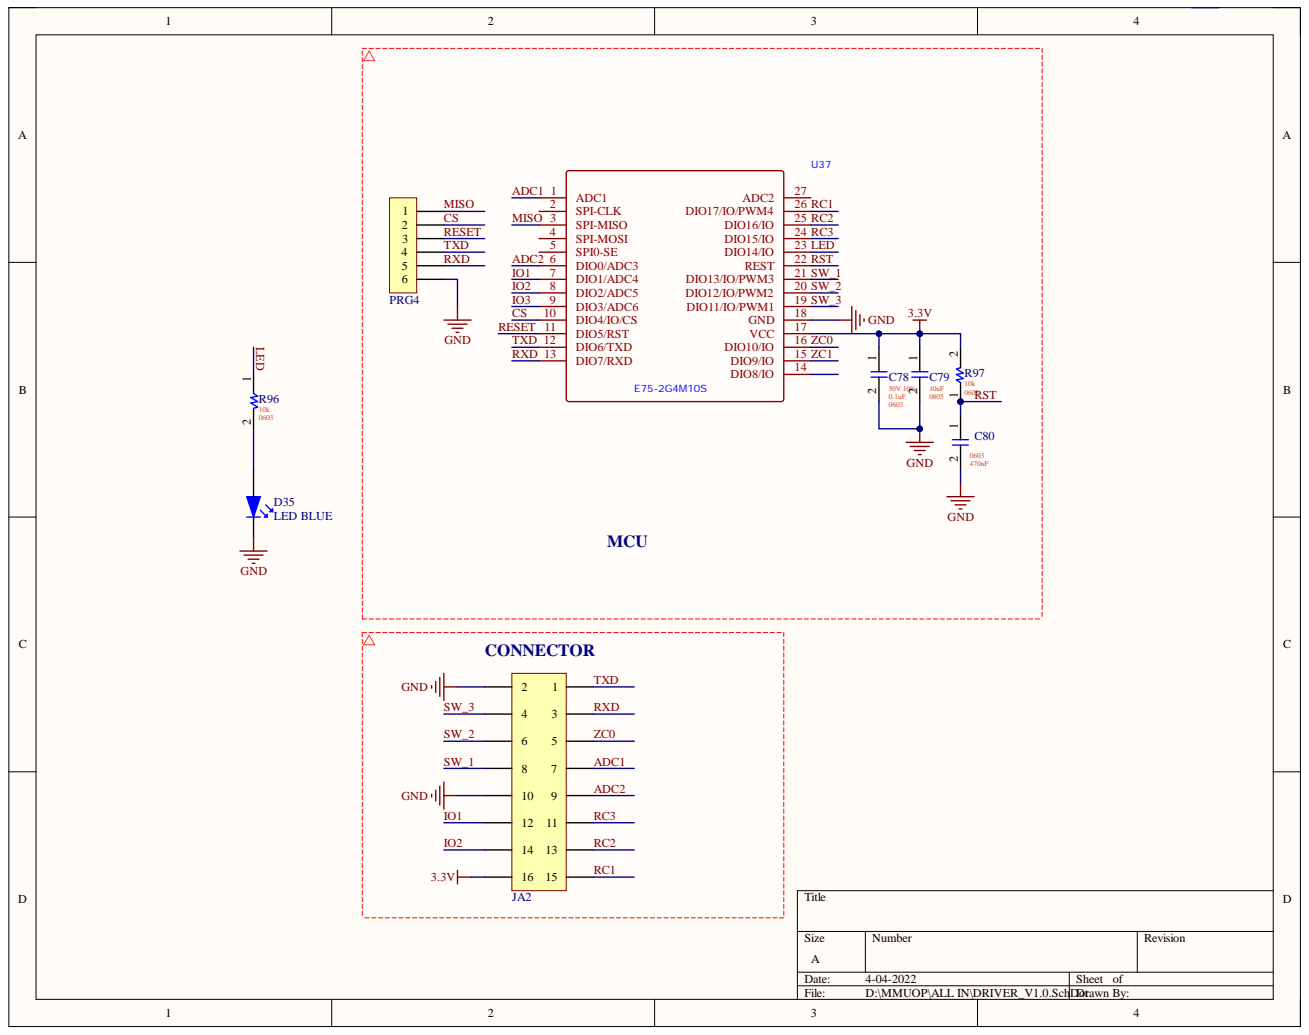
[picture p6: page 1]

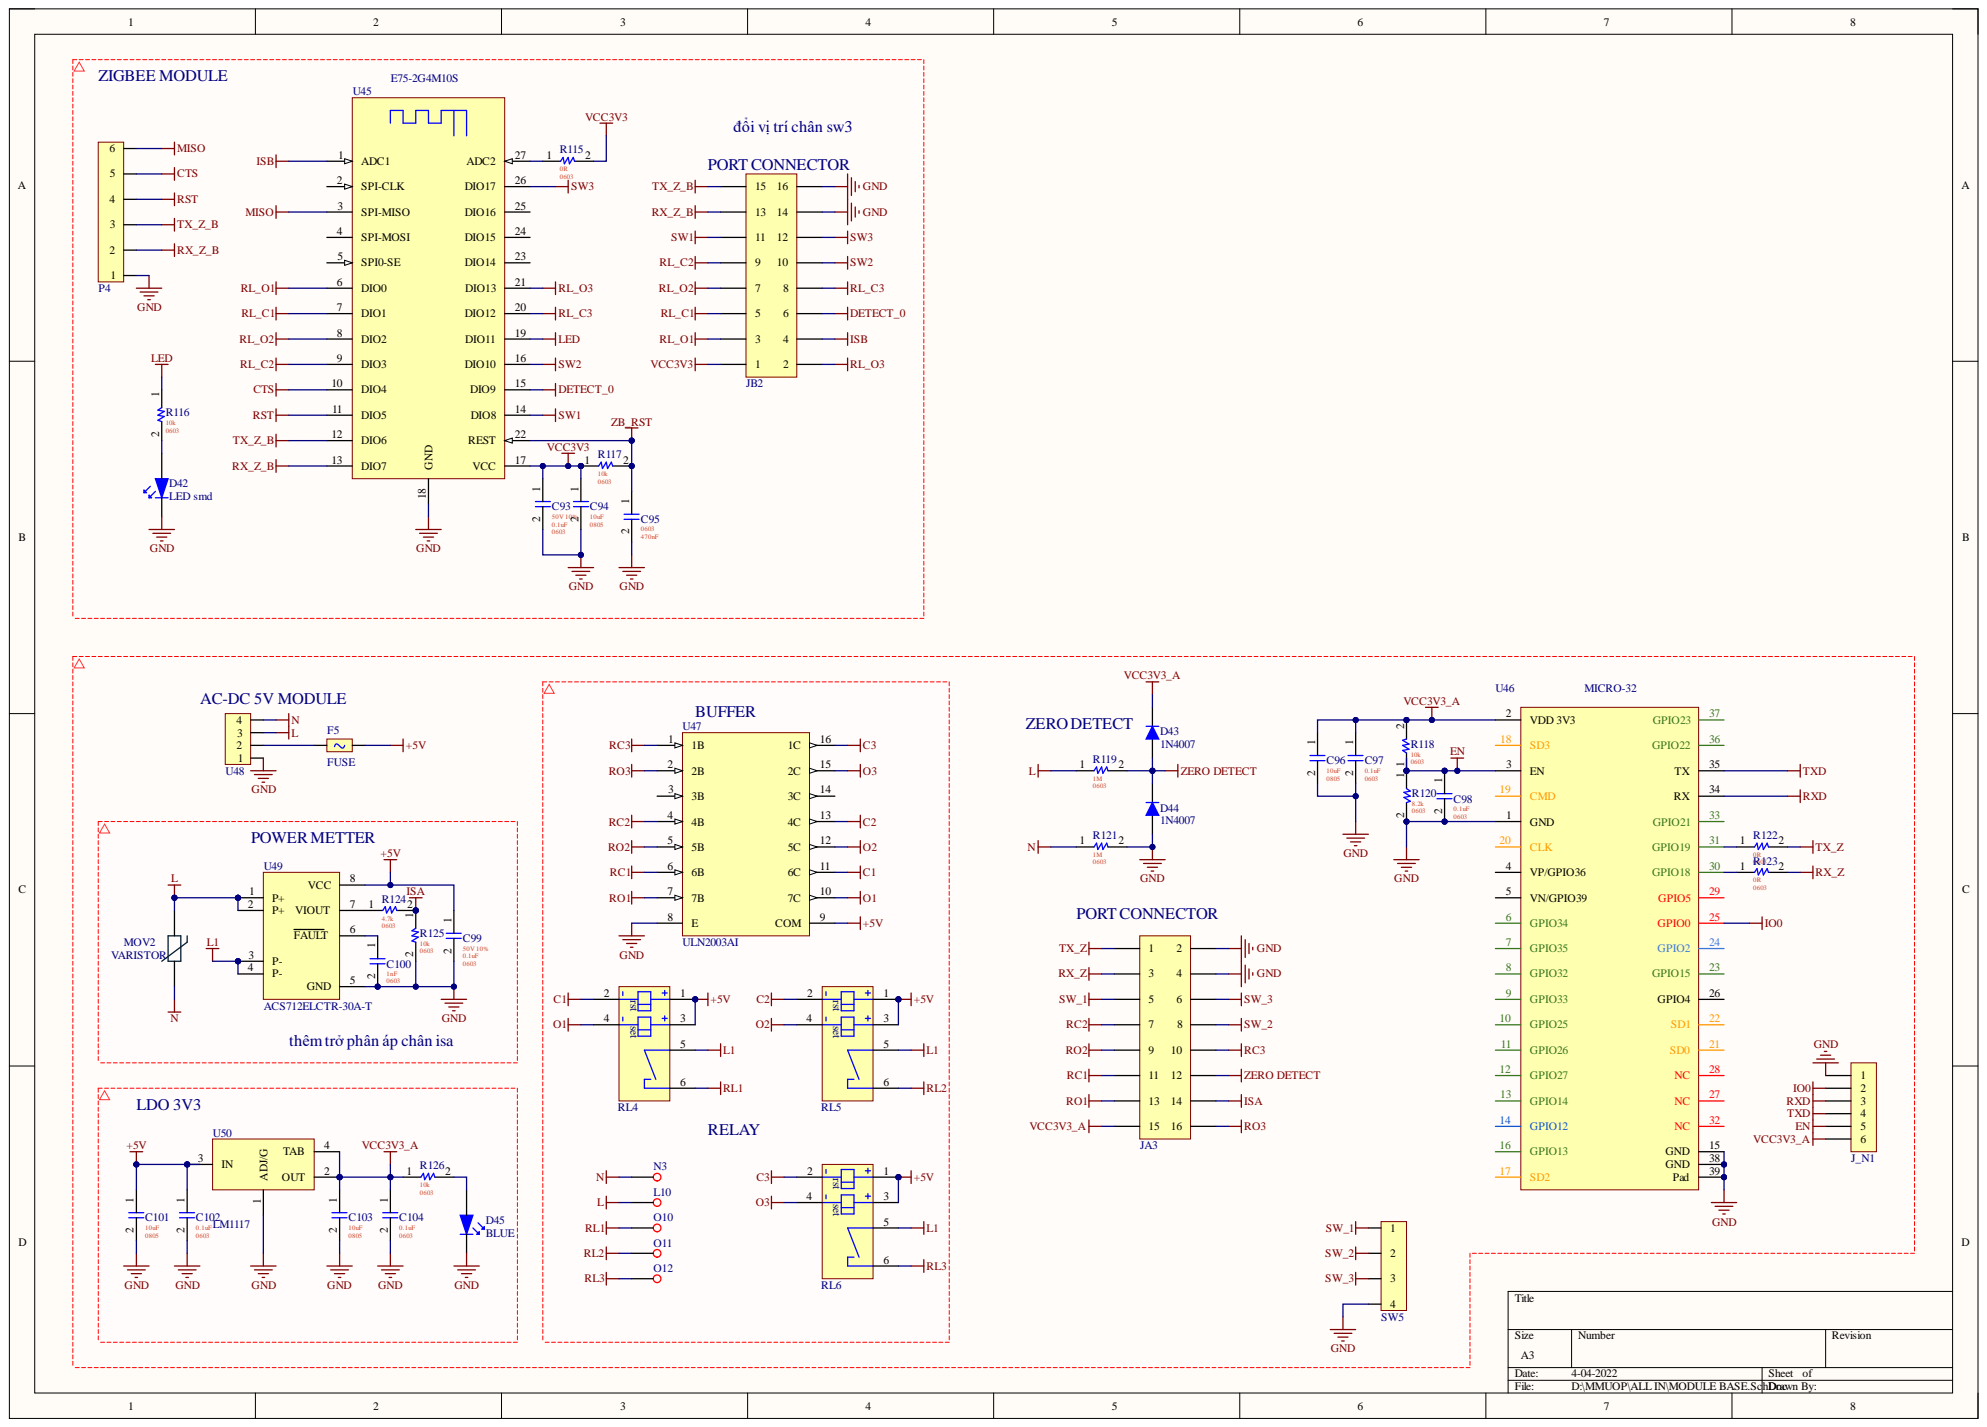
[picture p7: page 2]

đổi vị trí chân sw3 VCC3V3

thêmtrở phân áp chân isa

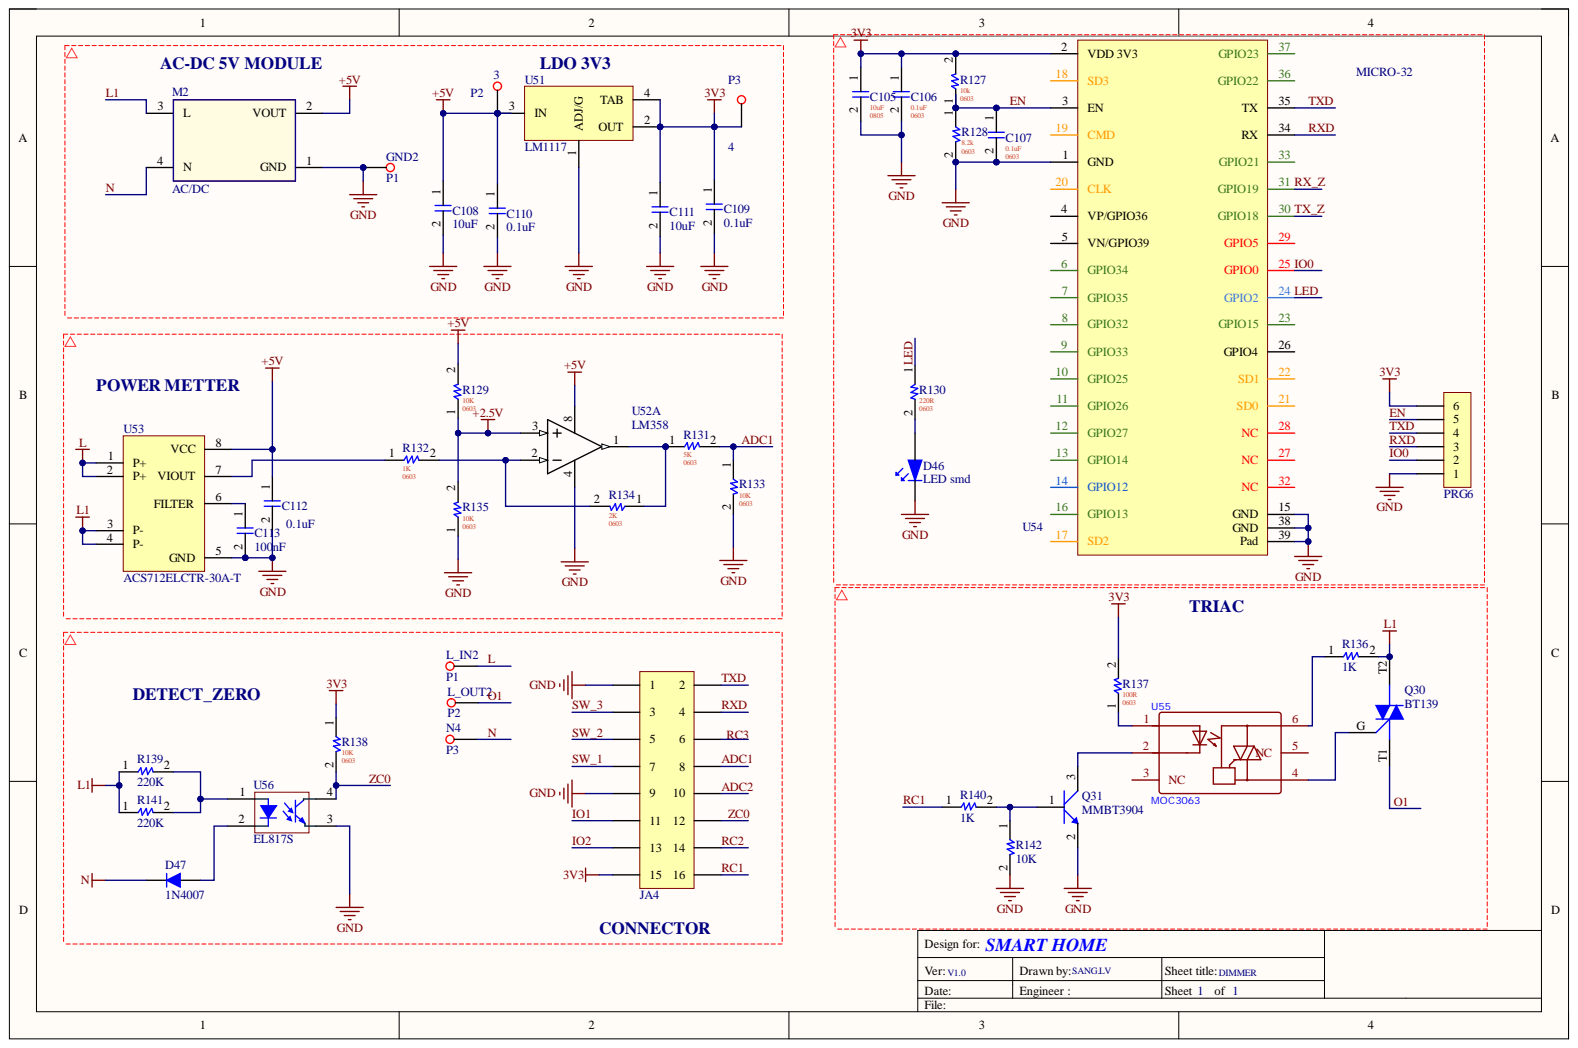
[picture p8: page 3]

Design for: SMART HOME

Ver: V1.0 | Drawn by: SANG.LV | Sheet title: DIMMER
Date: | Engineer : | Sheet 1 of 1

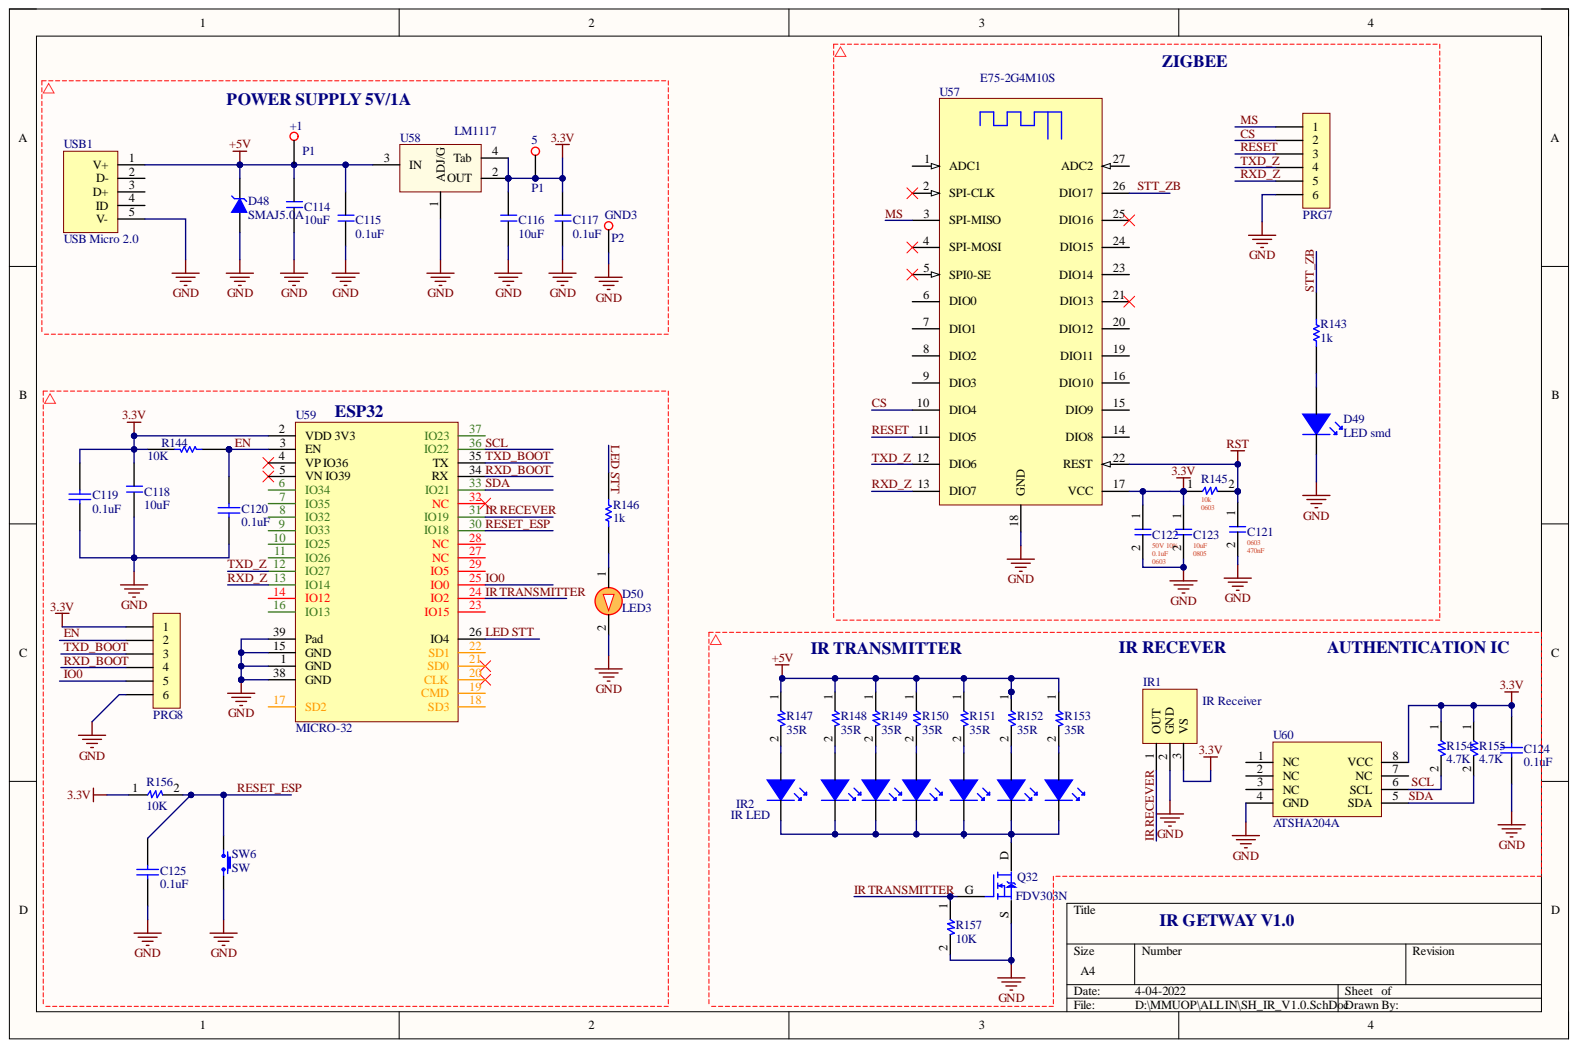
[picture p9: page 4]

F ile : D:\MMUOP\A LL IN\SH_I R_V1.0. S chDo | cDr awn By:

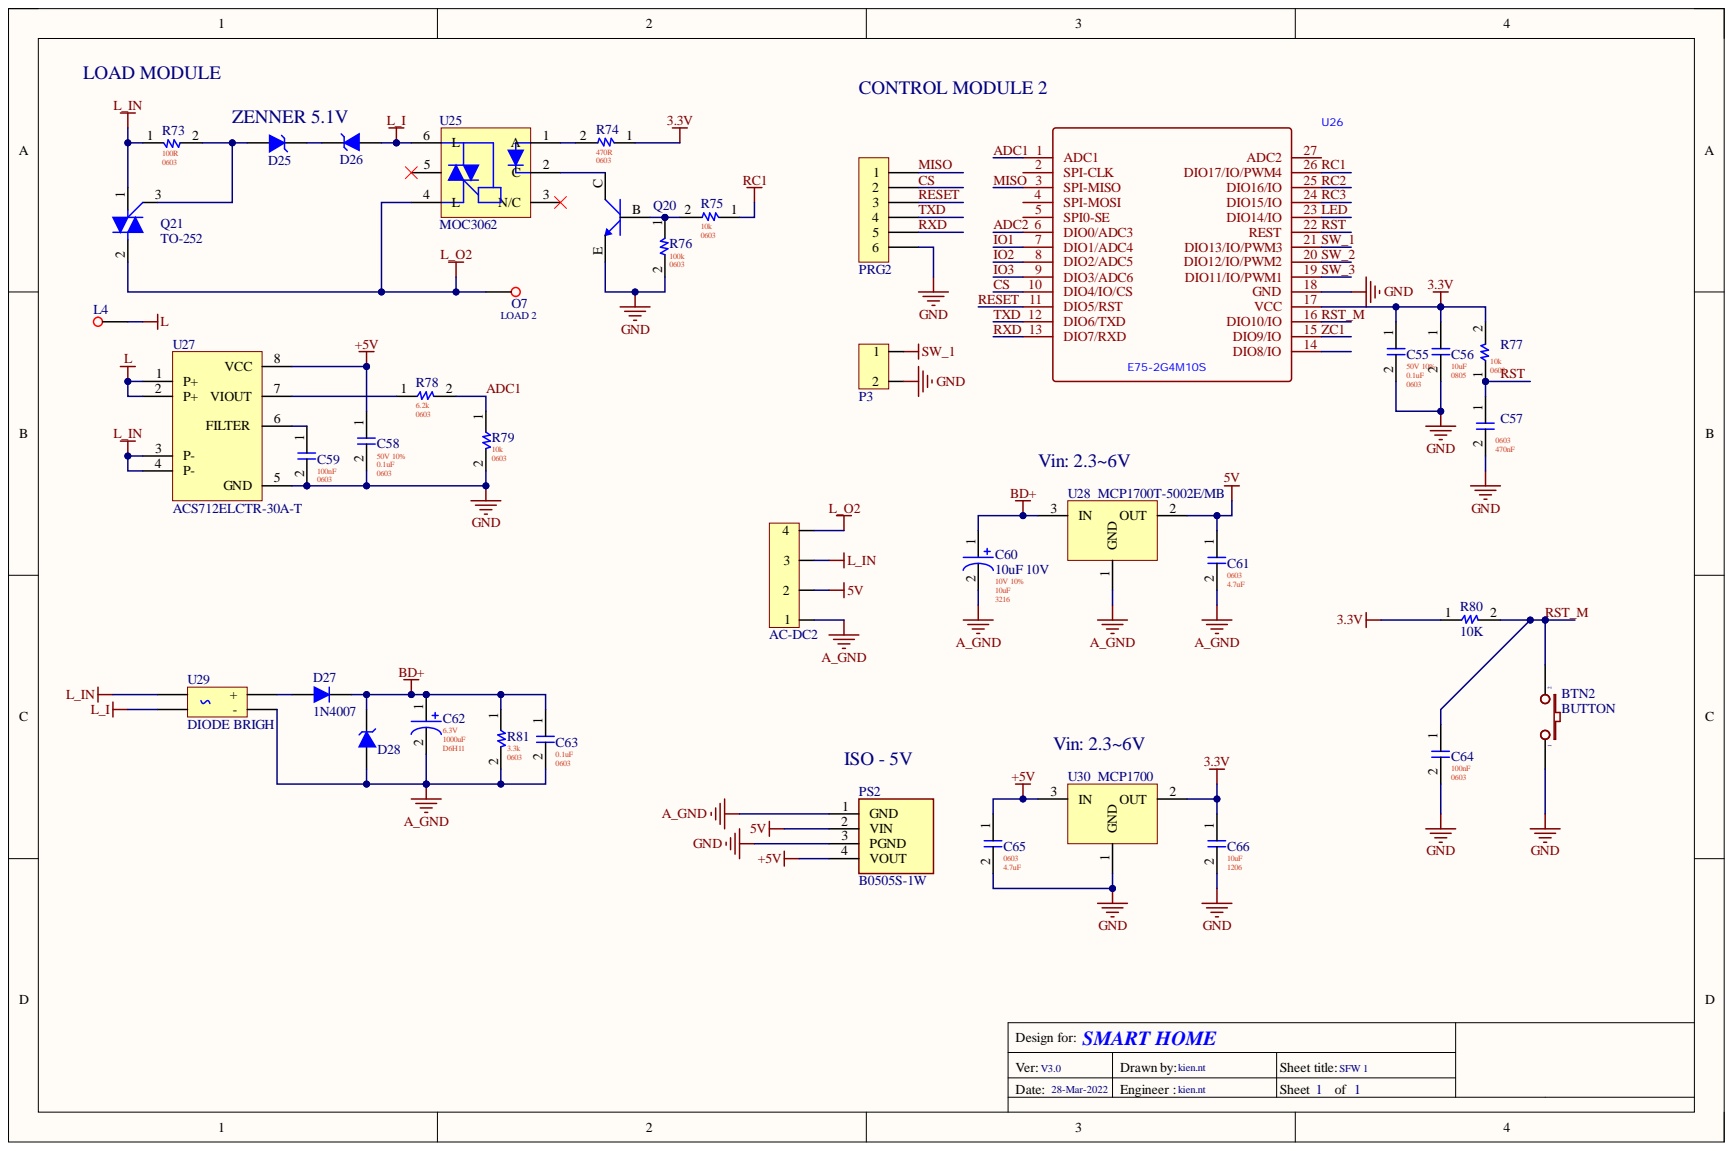
[picture p10: page 5]

Desi gn for : SMART H OME

Ve r : V3.0 | Dr awn by: kien.n t | She et titl e : SFW 1
Date : 28-Mar -2022 | Eng ine e r : kien.n t | She e t 1 of 1

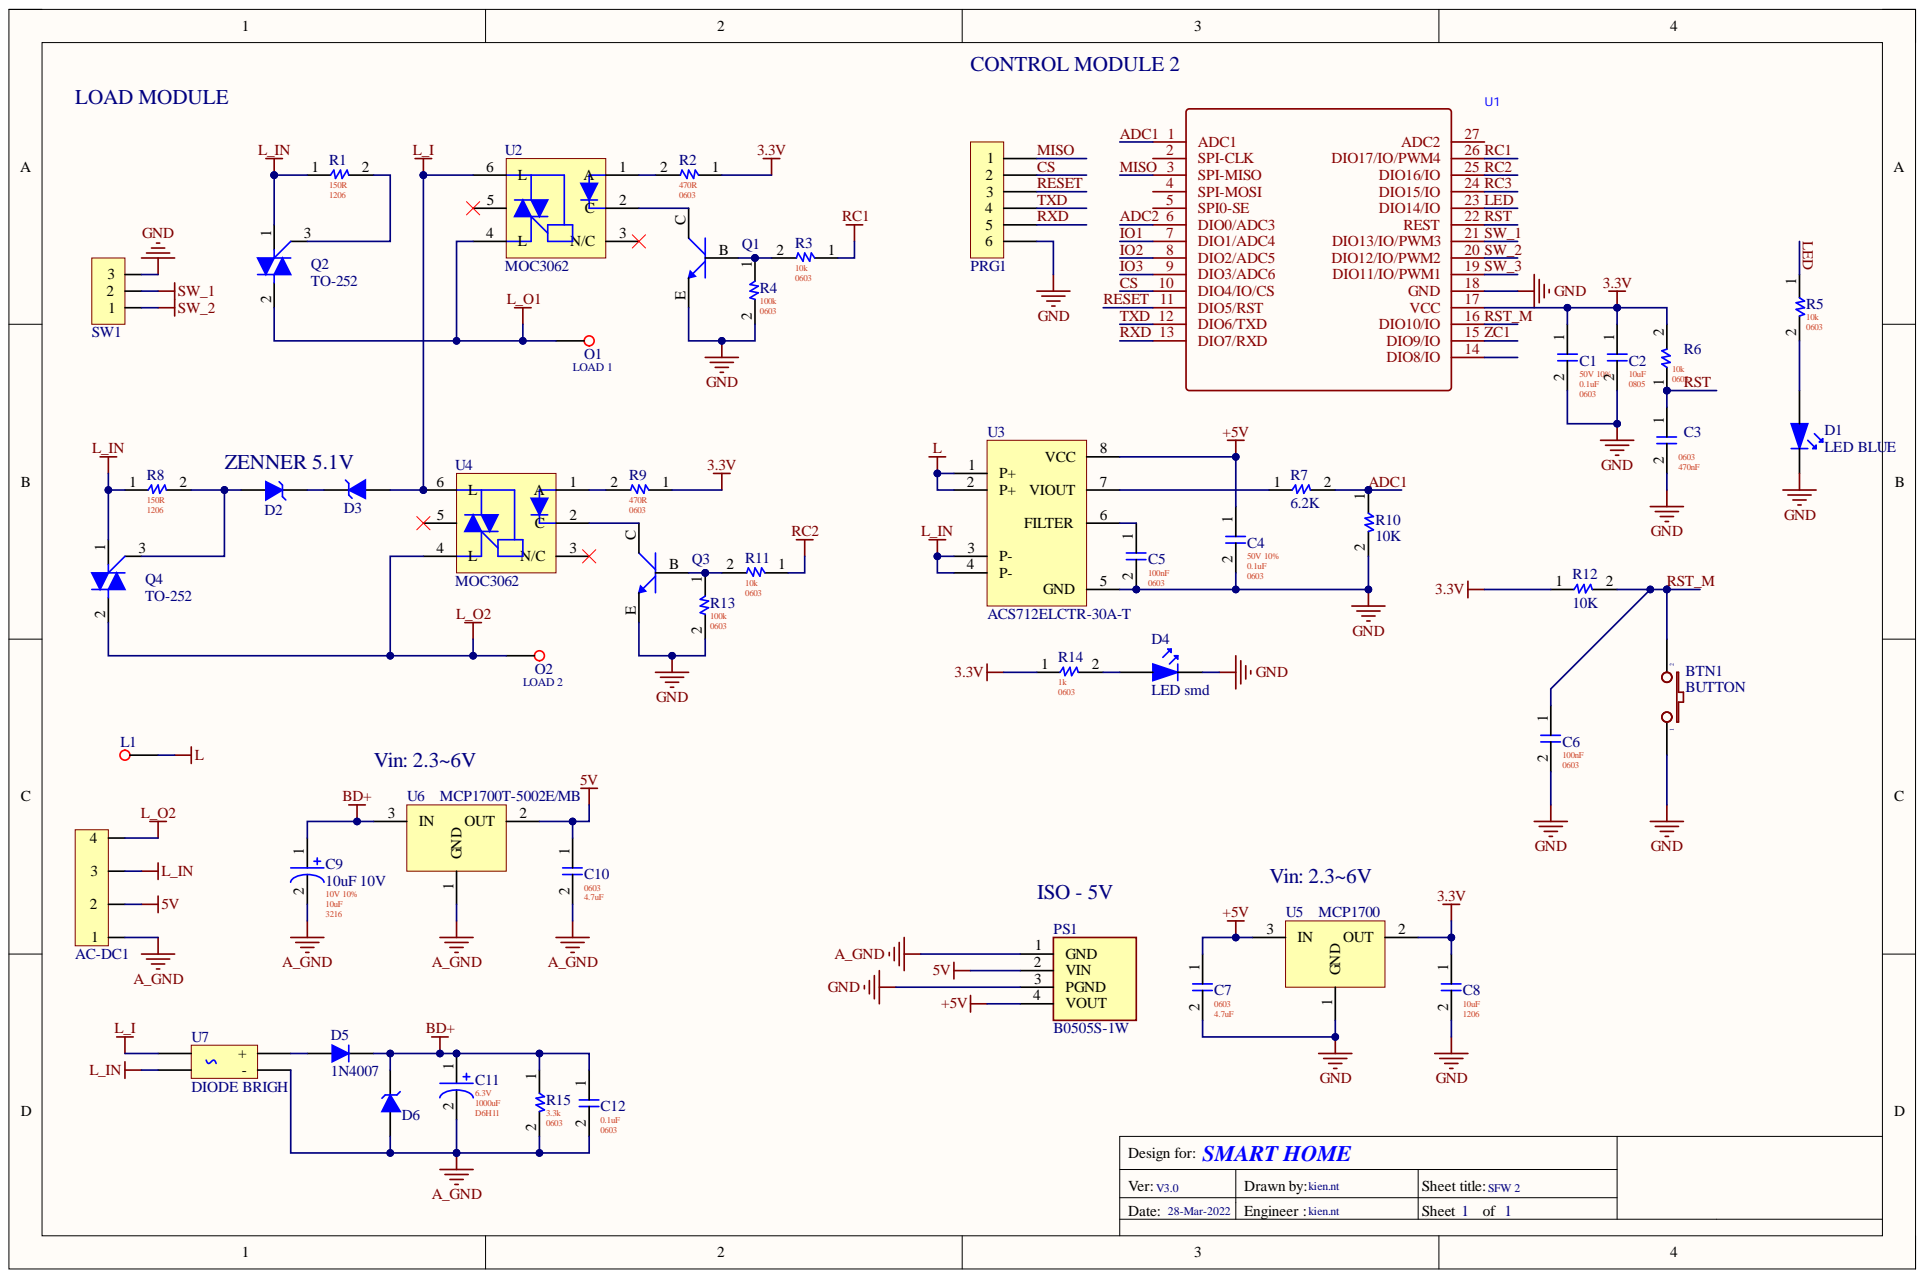
[picture p11: page 6]

Desi gn for : SMART H OME

Ve r : V3.0 | Dr awn by: kien.n t | She et titl e : SFW 2
Date : 28-Mar -2022 | Eng ine e r : kien.n t | She e t 1 of 1

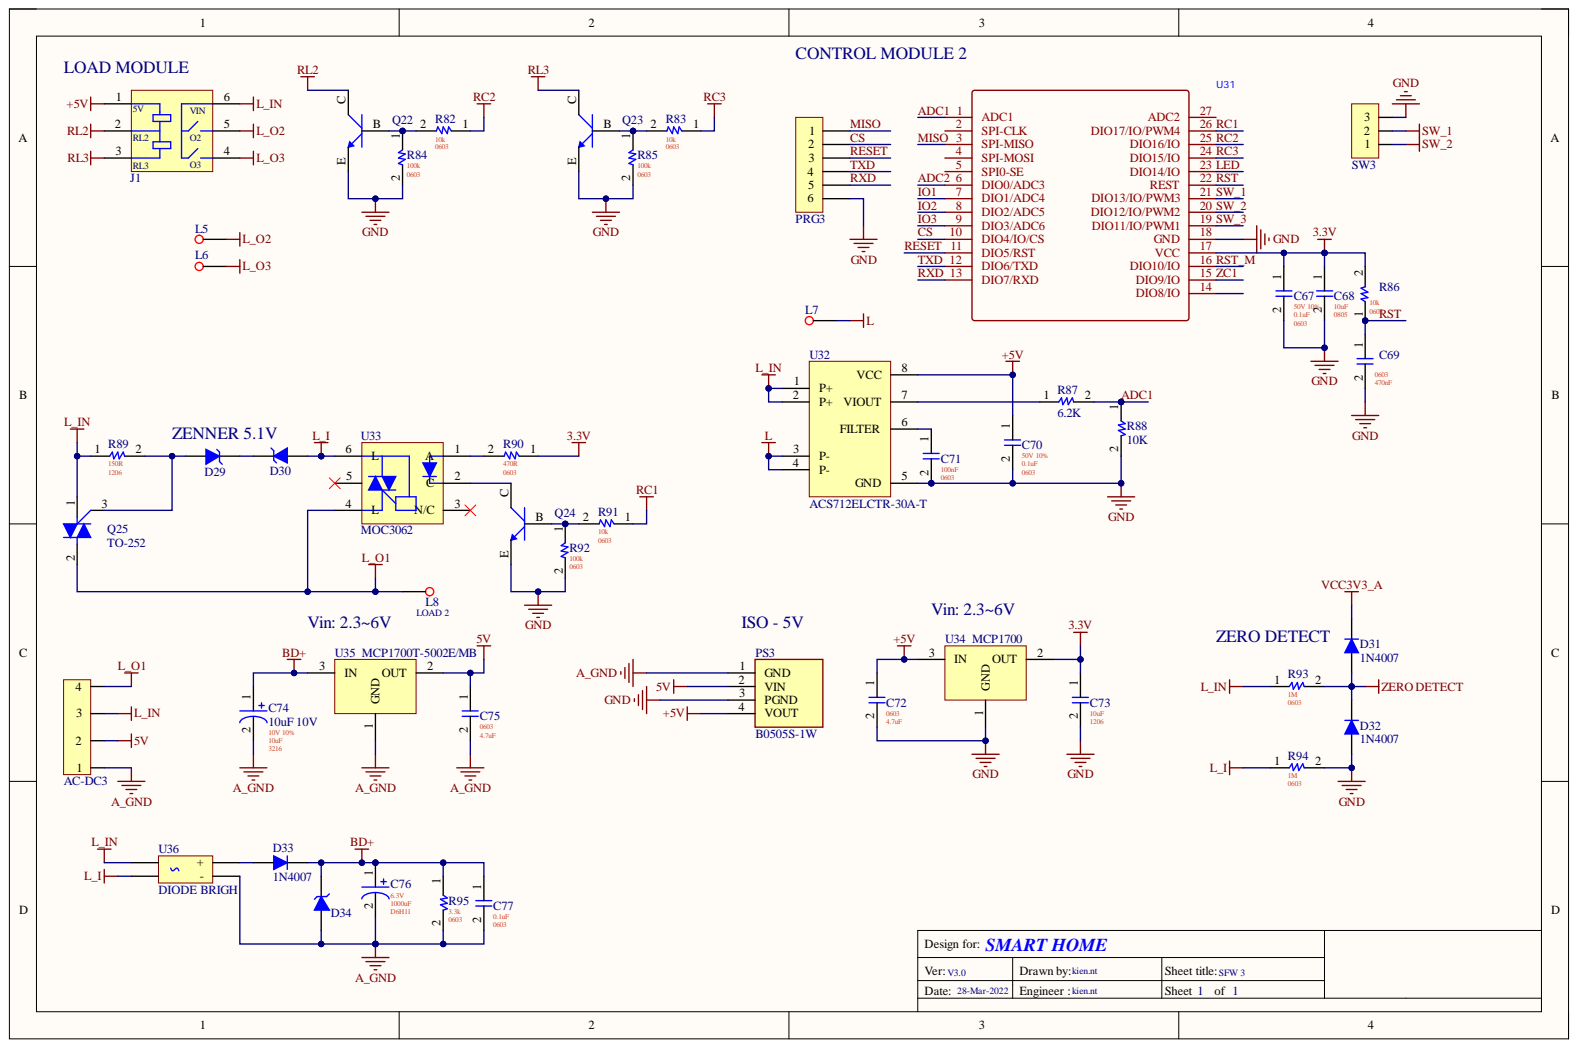
[picture p12: page 7]

Design for: SMART HOME

Ver: V3.0 | Drawn by: kien.nt | Sheet title: SFW 3
Date: 28-Mar-2022 | Engineer : kien.nt | Sheet 1 of 1

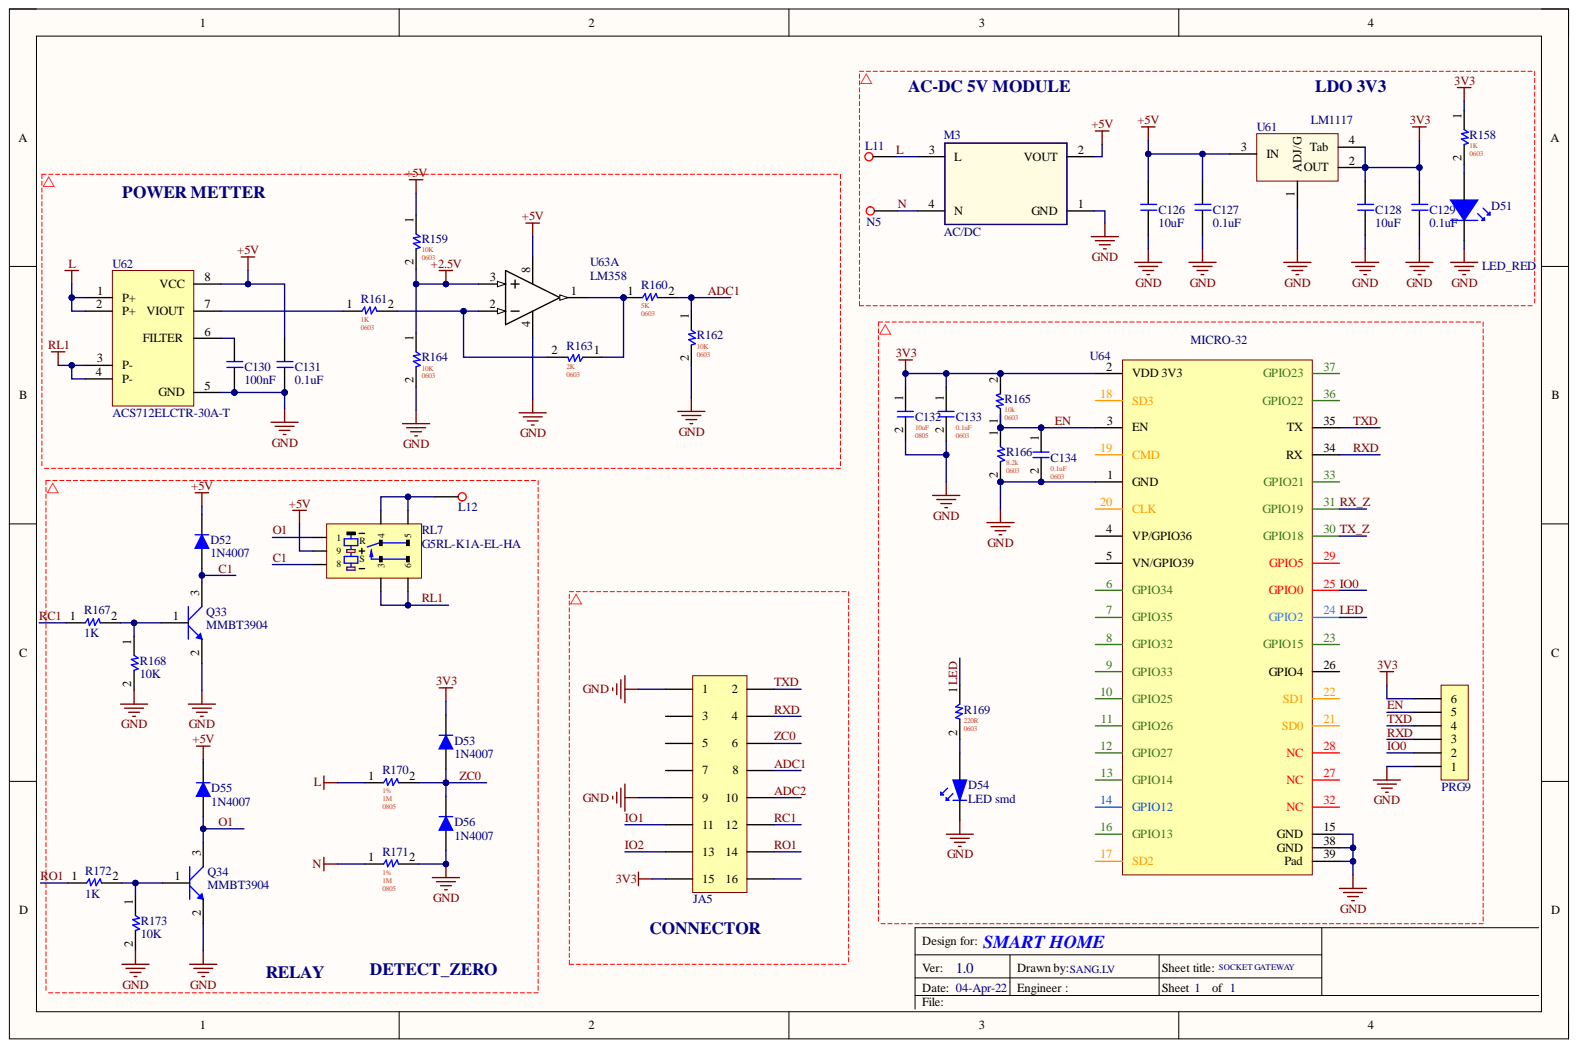
[picture p13: page 8]

SMART H OME Desi gn for :

Ve r : 1 . 0 | Dr awn by: SA N G . LV | She et titl e : SOCKET GATEWAY

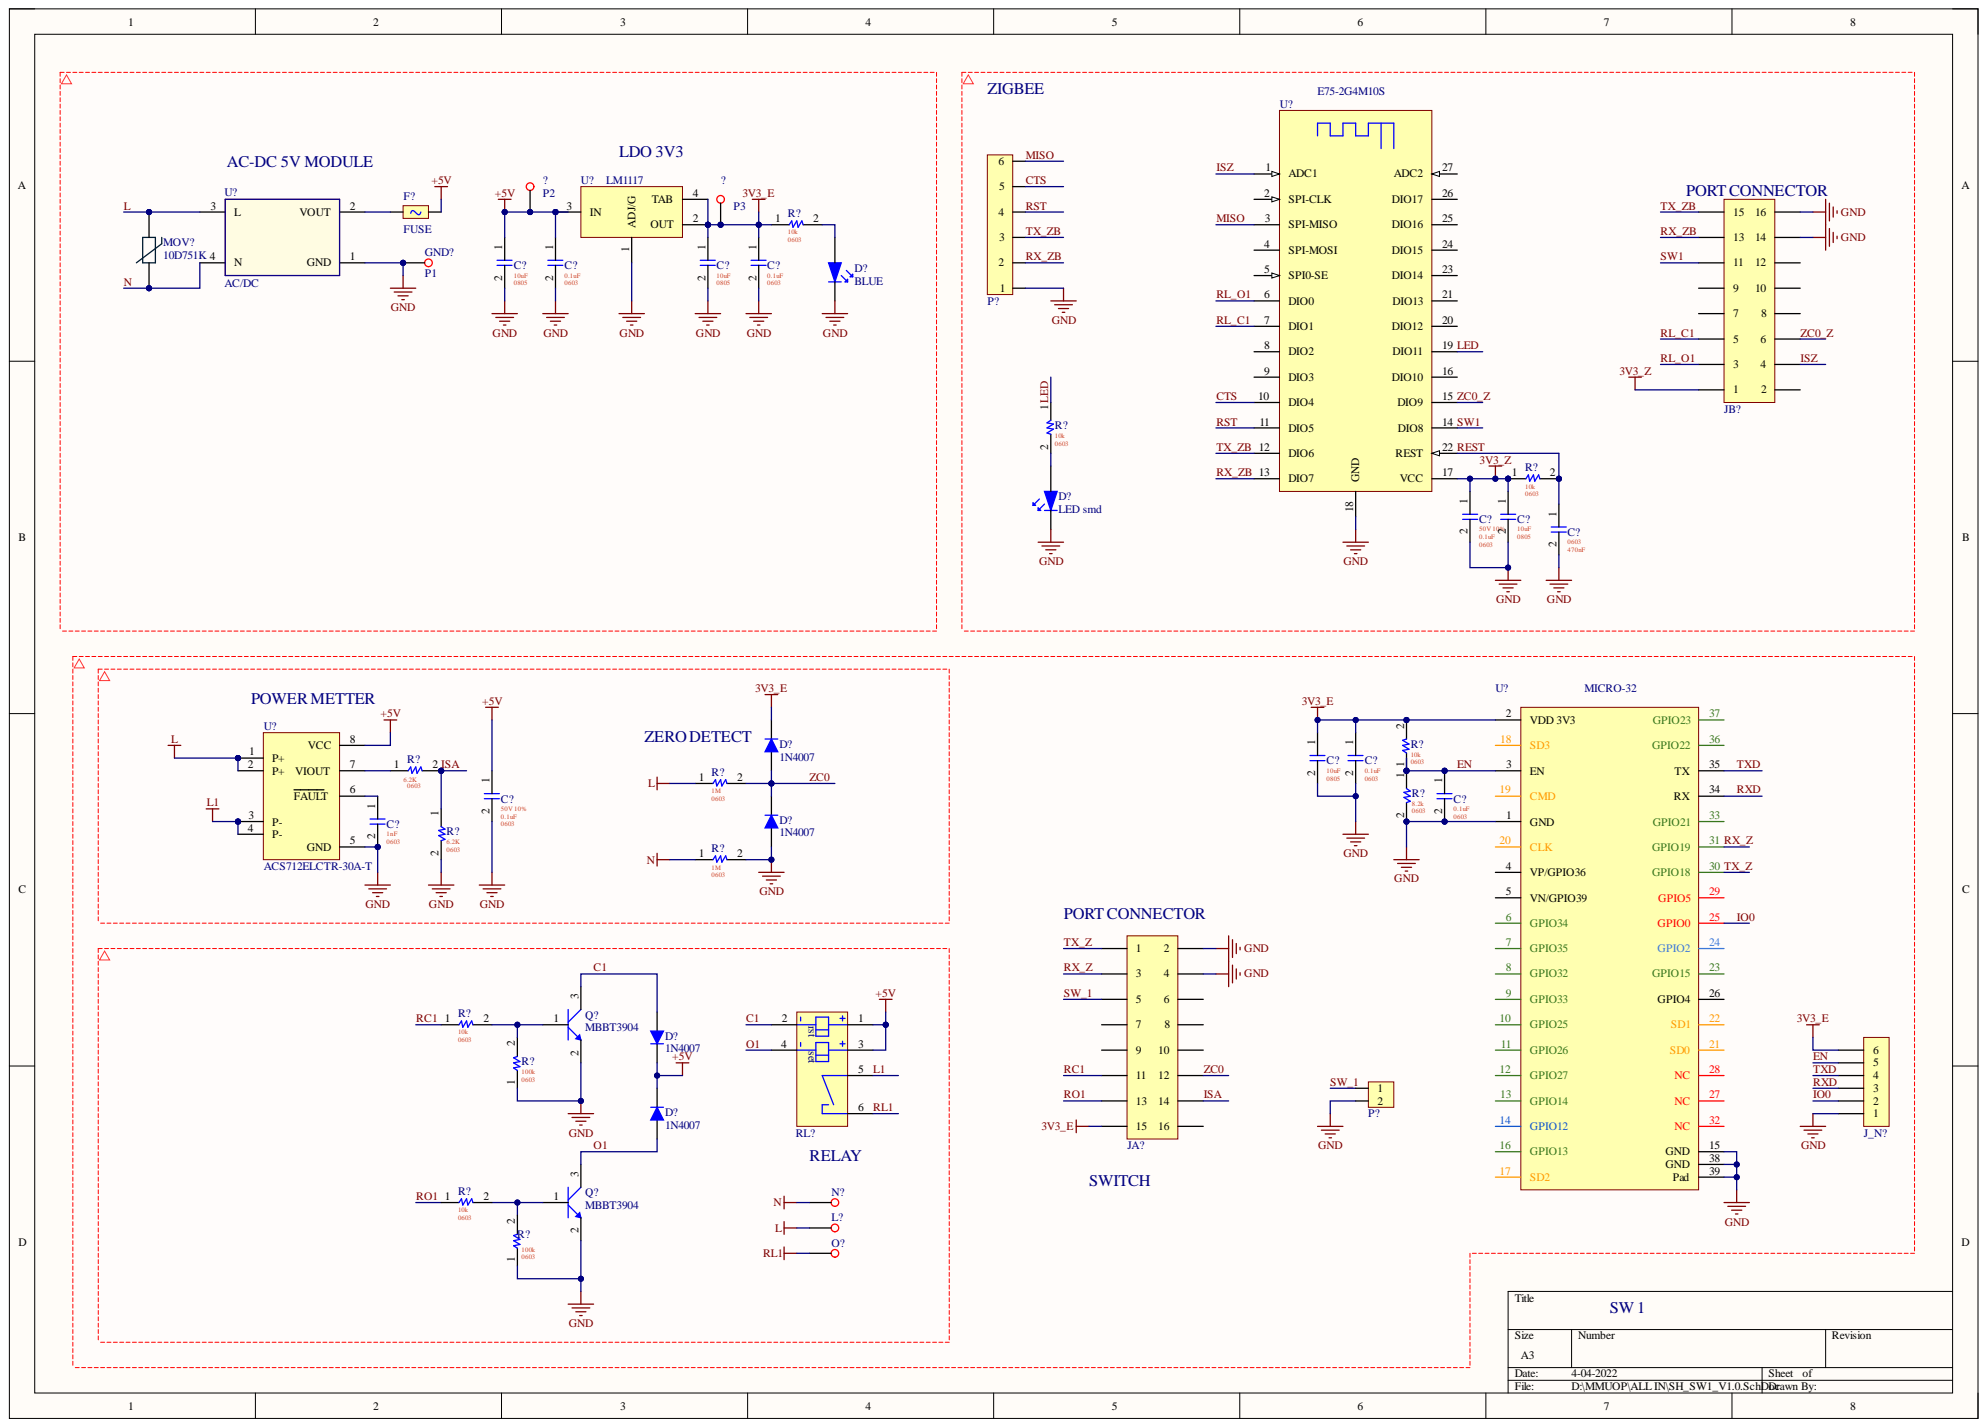
[picture p14: page 9]

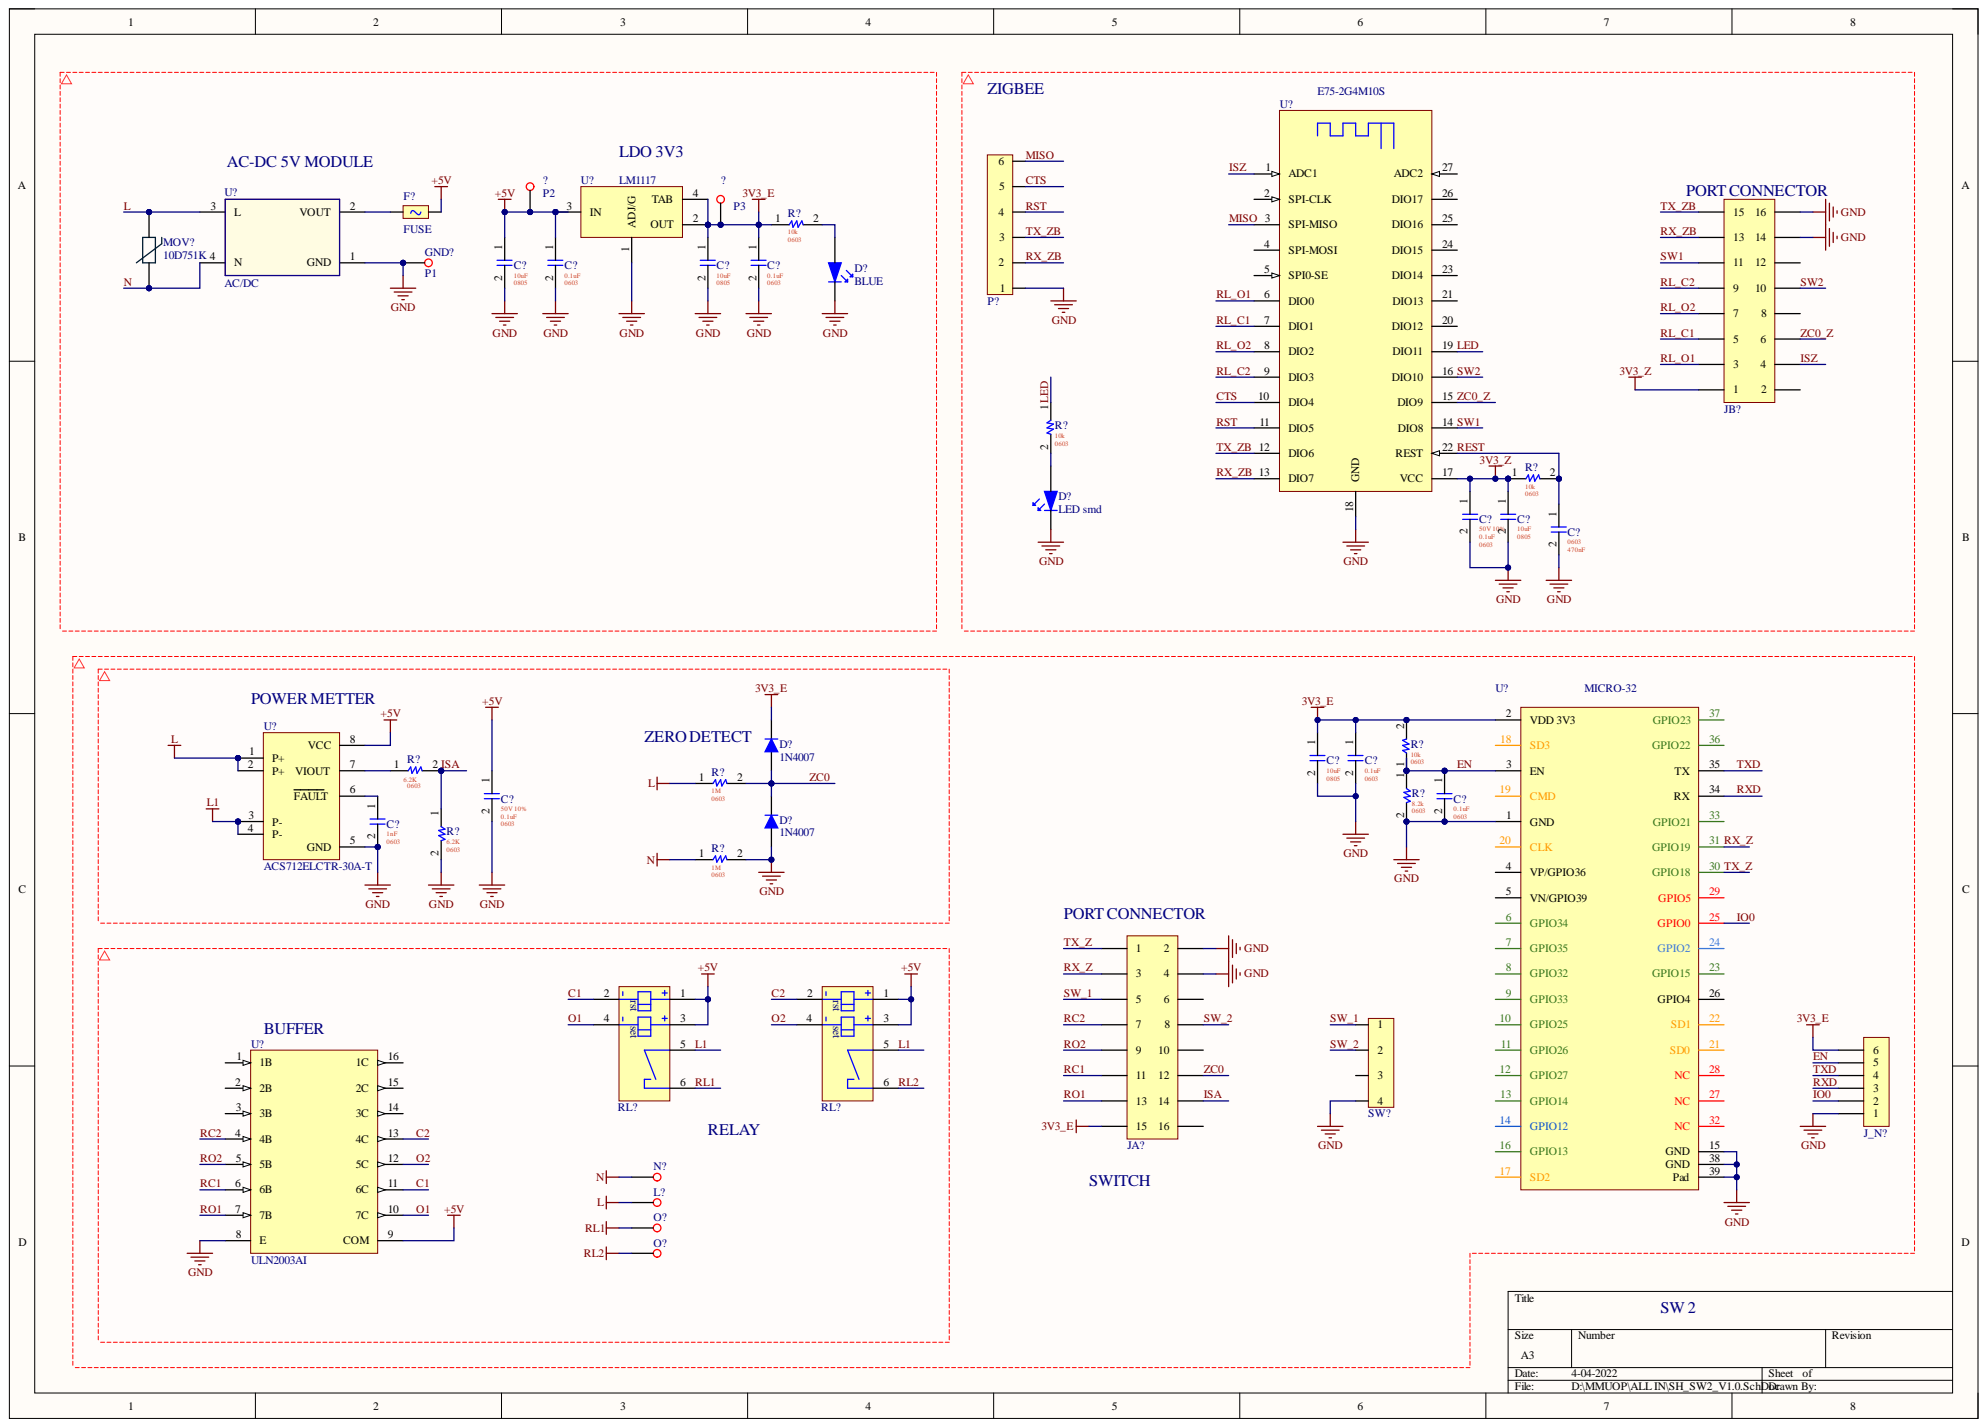
[picture p15: page 10]

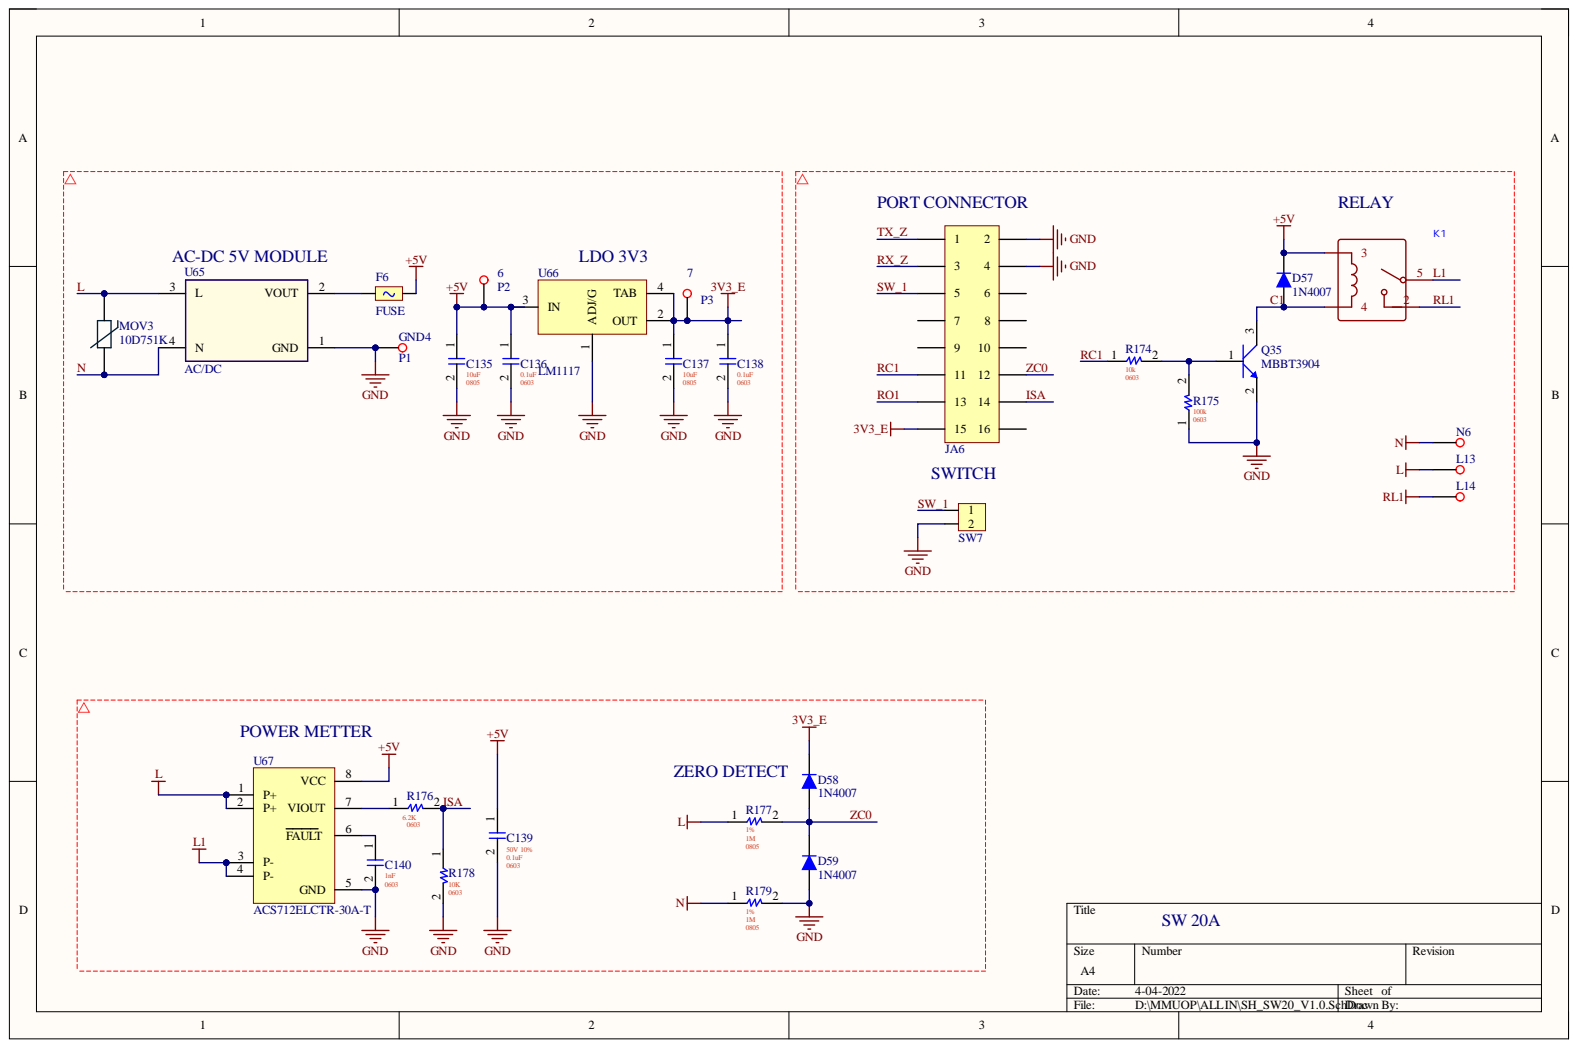
[picture p16: page 11]

Size A4 | Number | Revision

Date: 4-04-2022 | Sheet of
File: D:\MMUOP\ALLIN\SH_SW20_V1.0.SchDo Dracwn By:

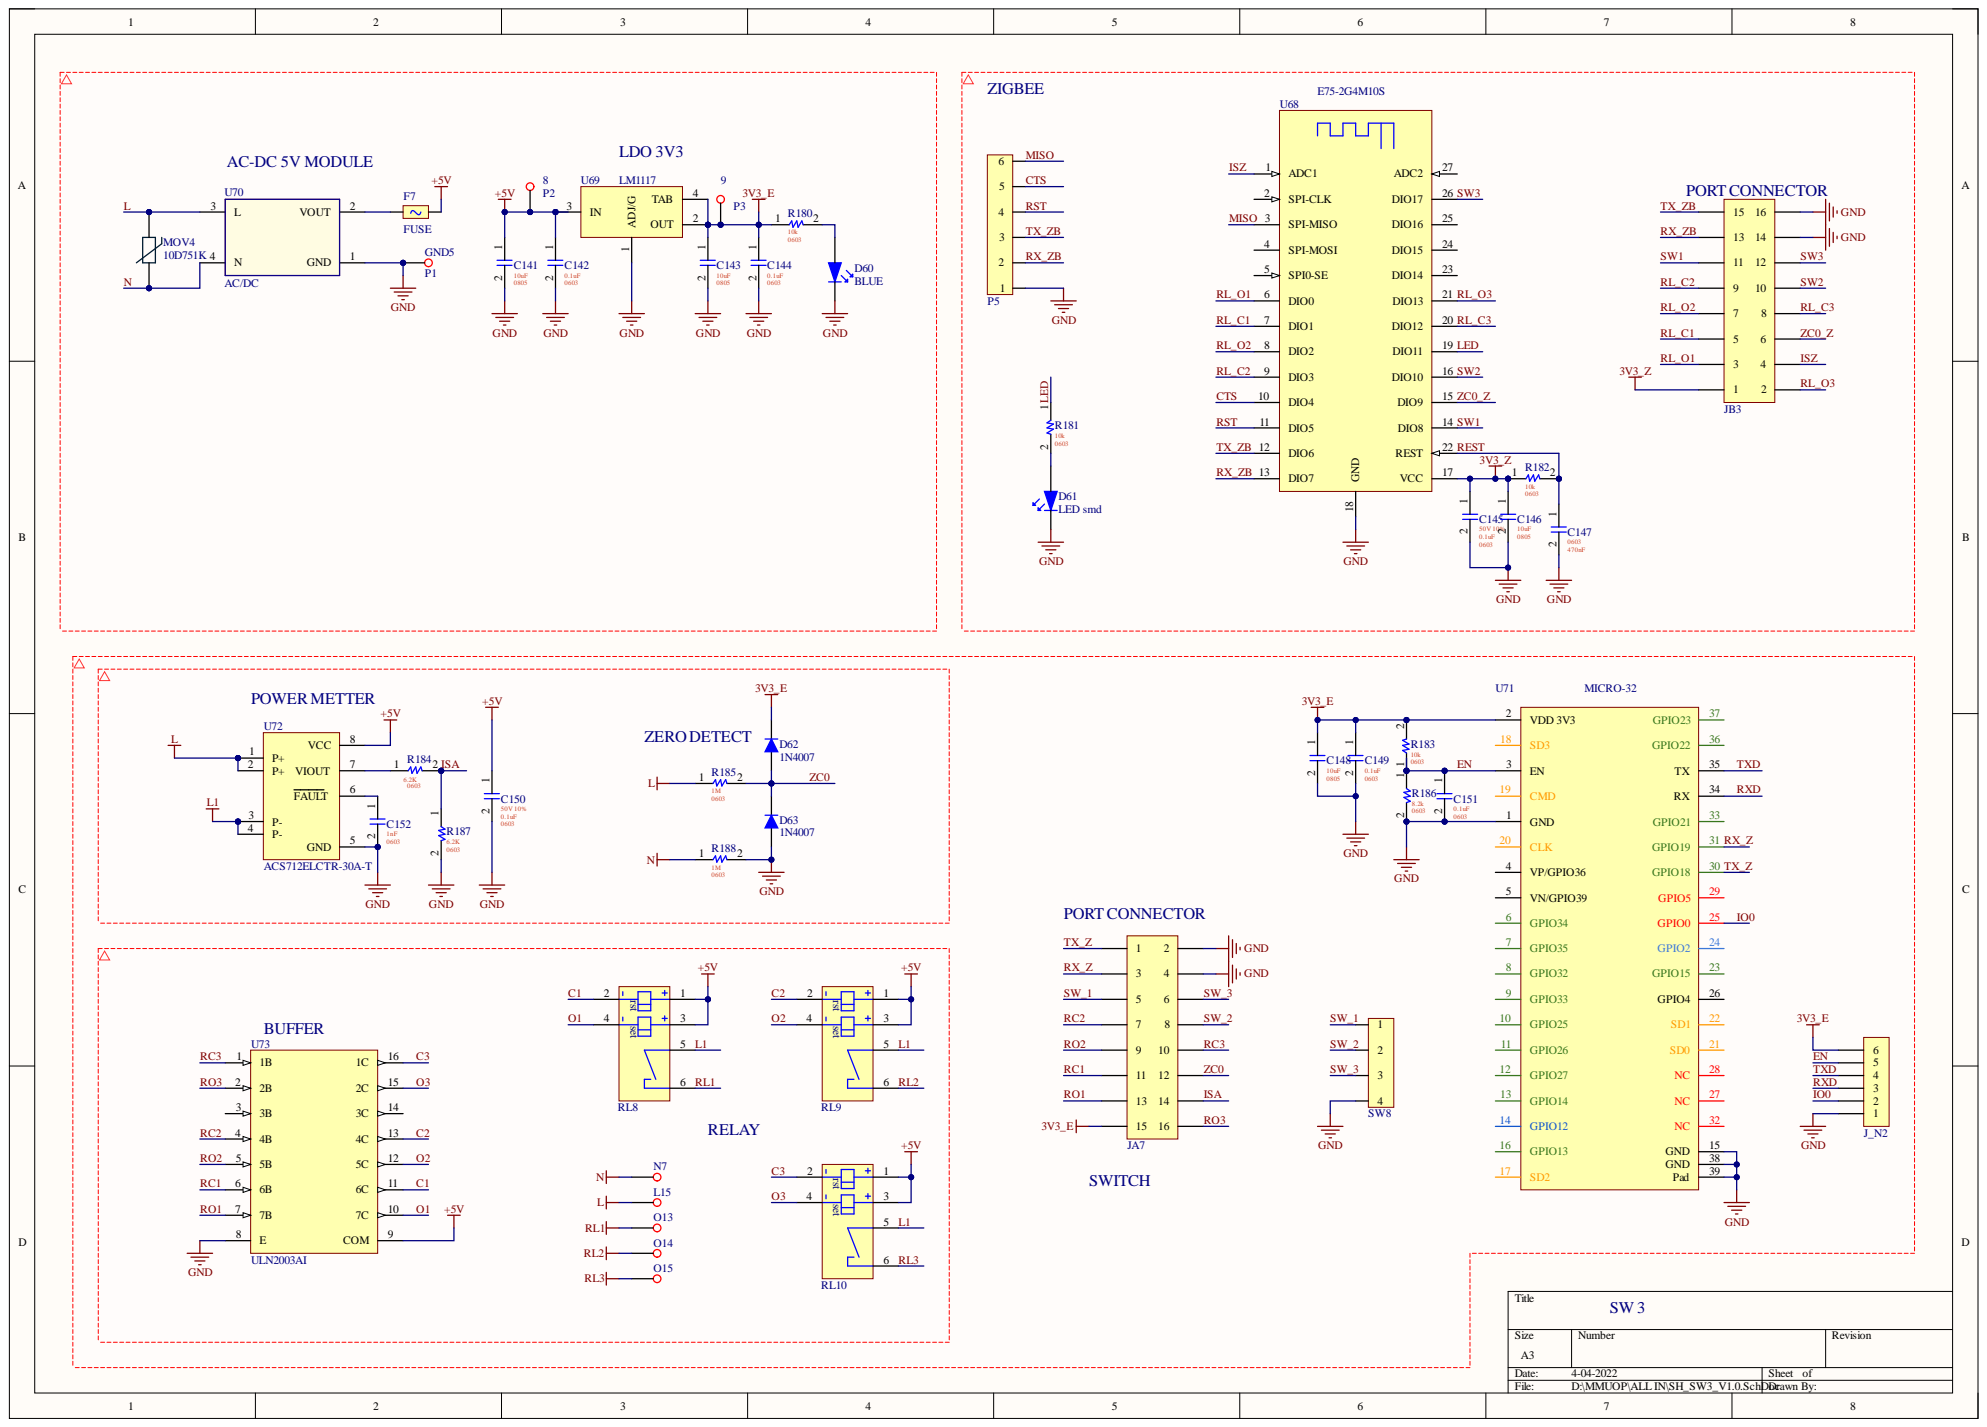
[picture p17: page 12]
