WOSS-SmartHome/-smart-home-DOC/SMARTHOME - diagram.pdf

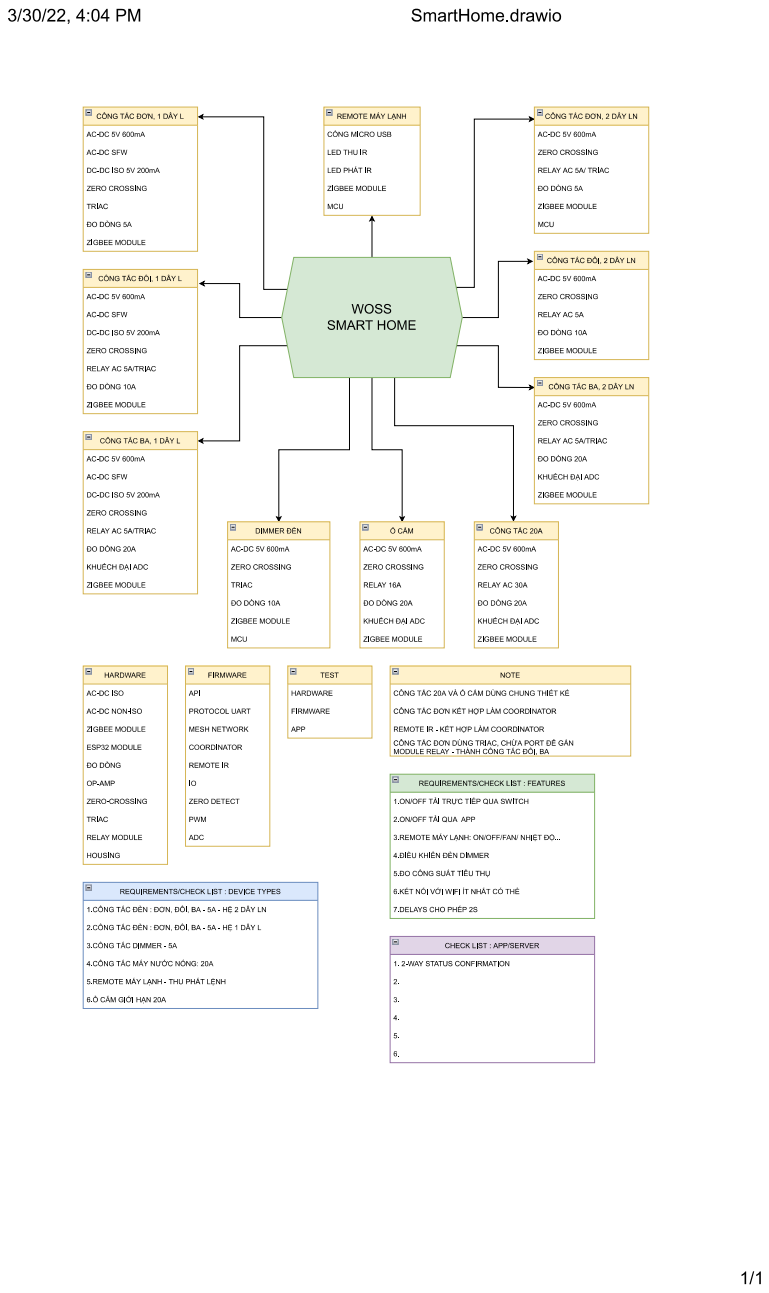
[picture p18: page 1]
