WOSS-SmartHome/-smart-home-DOC/Device SH Diagram.pdf

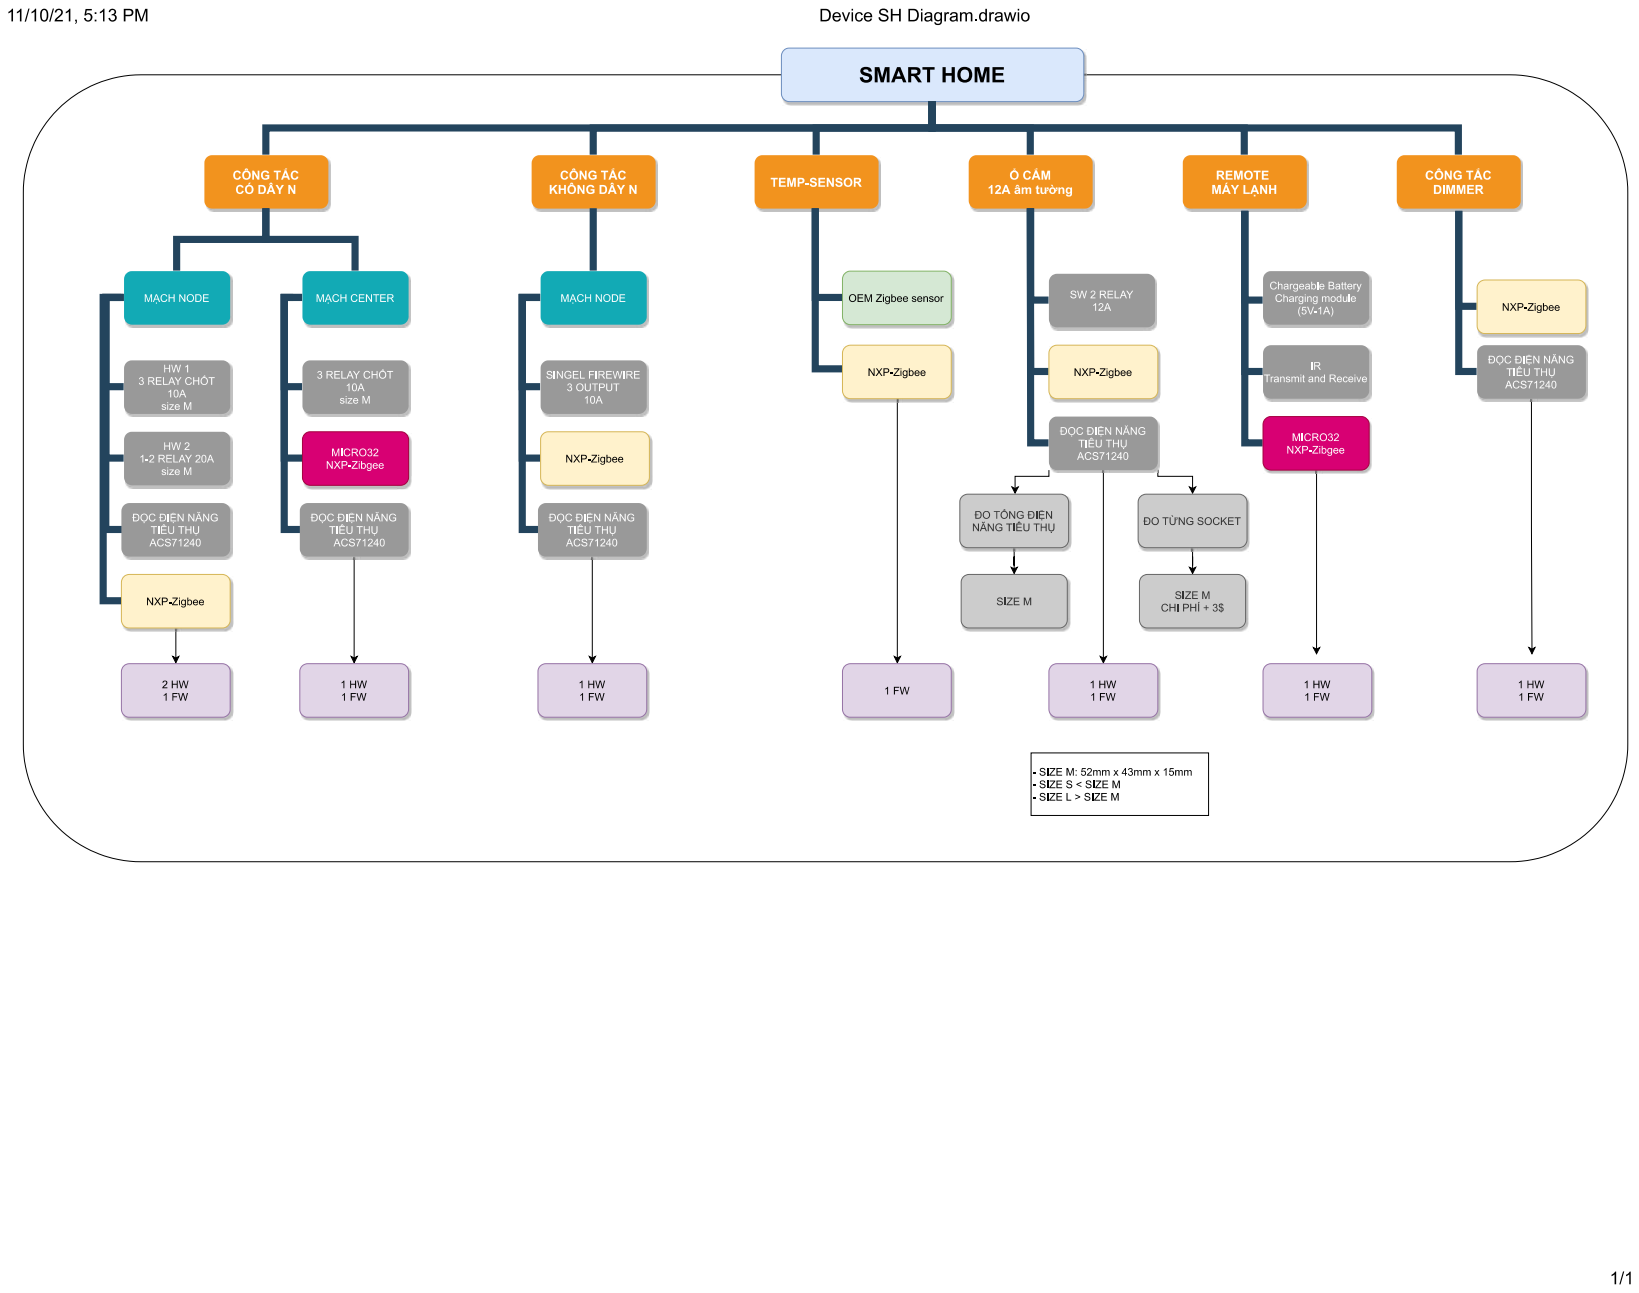
[picture p19: page 1]
