WOSS-SmartHome/-smart-home-DOC/(list of files, drawings)

Other design files:
Schematic_HW_SH/[SH][IR] V1.0.SchDoc
Schematic_HW_SH/[SH][SFW1] V1.0.SchDoc
Schematic_HW_SH/[SH][SFW2] V1.0.SchDoc
Schematic_HW_SH/[SH][SW1] V1.0.SchDoc
Schematic_HW_SH/[SH][SW2] V1.0.SchDoc
Schematic_HW_SH/[SH][SW3] V1.0.SchDoc
Schematic_HW_SH/[SH][SW20] V1.0.SchDoc
