WOSS-SmartHome/-smart-home-DOC/(commit log)

2021-09-21 git add
    [BOM list smarthome 6-sep.xlsx]
2021-10-30 test module zigbee V0
    [Daily_Testing_Module-Zigbee-Ti-CC2530.xlsx]
2021-11-01 file Test Case SmartHome V0
    [Test-Case_Smart-Home_V0.xlsx]
2021-11-09 New Test Case for Node
    [TEST CASE_SH_New_V0.xlsx]
2021-11-10 update Test case New
    [TEST CASE_SH_New_V0.xlsx]
2021-11-10 Update Tesst case Switch day 3
    [TEST CASE_SH_New_V0.xlsx]
2021-11-11 update day 4
    [TEST CASE_SH_New_V0.xlsx]
2021-11-11 update day 4, time 2
    [TEST CASE_SH_New_V0.xlsx]
2021-11-18 up HDSD lap dat Node
    [TEST CASE_SH_New_V0.xlsx]
2021-12-21 git commit
    [NAme.xlsx]
